Gigahawk/mech223project/Report/src/report.tex

\documentclass{report}
\usepackage[subpreambles=true]{standalone}
\usepackage[utf8]{inputenc}
\usepackage{import}
\usepackage[titletoc]{appendix}
\usepackage[table]{xcolor}
\usepackage[acronym,toc,numberedsection]{glossaries}
\usepackage{chngcntr}

\makeglossaries

%Add star to first instance of text
\defglsentryfmt{
	\ifglsused{\glslabel}{\hspace{-3pt}\glsgenentryfmt\hspace{-6pt}}{\hspace{-3pt}\glsgenentryfmt *\hspace{-6pt}}
}
\newglossaryentry{funcdecomp}{
	name={functional decomposition},
	description={The breakdown of a complex design into numerous, simpler tasks that the overall design must complete}
}
%\setacronymstyle{long-short}
%\newacronym[description={A quantitative method of scoring that assesses the performance of concepts across weighted criteria using absolute scoring}]{wdmacr}{WDM}{weighted decision-making matrix}
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
	description={The tasks that every design-to-be must complete}
}
\newglossaryentry{conceptfrags}{
	name={concept fragment},
	description={Possible solution to a given function}
}
\newglossaryentry{morph}{
	name={morphological chart},
	description={A methodical way of combining various concept fragments into whole concepts}
}
\newglossaryentry{pot}{
	name={potentiometer},
	description={A component that varies its electrical resistance based on the displacement of the dial on its face from its original position}
}

\newglossaryentry{arduino}{
	name={Arduino},
	description={Integrated computer onto a circuit board that receives input from computer programs and drives output}
}
\newglossaryentry{photores}{
	name={photoresistor},
	description={A component that varies its electrical resistance based on the amount of light it detects}
}
\newglossaryentry{wholeconc}{
	name={whole concept},
	description={Potential complete solution for a design}
}
\newglossaryentry{prototype}{
	name={prototype},
	description={A preliminary or final model that built to test the whole concept and collect information for further improvement}
}

\newglossaryentry{torque}{
	name={torque},
	description={Rotational force that causes the object to rotate about its centre}
}

\newglossaryentry{stalltorqure}{
	name={stall torque},
	description={Produced torque from a device outputs in no rotational motion (zero angular velocity). (it might be caused due to overload of the system)}
}

\newglossaryentry{drumbrake}{
	name={drum brake},
	description={Type of brake that uses friction pads to stop rotation of wheels}
}

\newglossaryentry{axle}{
	name={axle},
	description={Shaft that connects and/or drives two wheels}
}

\newglossaryentry{conical}{
	name={conical wheels},
	description={The shape of wheels commonly used for locomotive wheels which allow turning around corners}
}
\newglossaryentry{gearbox}{
	name={gearbox},
	description={Machine that transmits mechanical power through meshing gears}
}

\newglossaryentry{winnow}{
	name={winnowing},
	description={Process that is used to screen out concepts based on feasibility, requirements, and technical readiness}
}
\newglossaryentry{techready}{
	name={technical readiness},
	description={Process of researching for availability and ease of manufacturing, operating, and disposing}
}
\newglossaryentry{eval}{
	name={Evaluation},
	description={One of the design stages which involves concept evaluation and selection using qualitative (Pugh Chart, WDM, etc.) and quantitative methods (calculations)}
}
\newglossaryentry{datum}{
	name={Datum},
	description={Well-known design that is used as reference  }
}
\newglossaryentry{friction}{
	name={Friction},
	description={Type of contact force that always opposes motion}
}
\newglossaryentry{pla}{
	name={PLA},
	description={Commonly used 3D-printing material}
}
\newglossaryentry{pulleydrive}{
	name={pulley drive system},
	description={One type of power transmission that uses rubber belt that’s wrapped around two synchronically rotating pulleys of various sizes}
}
\newglossaryentry{chassis}{
	name={Chassis},
	description={The lower frame of the train which supports internal elements of the train}
}
\newglossaryentry{gyro}{
	name={Gyroscope},
	description={Sensory device that’s used for navigation and detection of angular velocity (orientation about a pivot) }
}

\newglossaryentry{gearratio}{
	name={Gear Ratio},
	description={Input speed on first gear relative to output speed on the last gear}
}

\newglossaryentry{motor}{
	name={Motor},
	description={Device that converts electrical energy to rotational energy}
}

\title{Design Considerations for an Electric Locomotive}
\author{Adrian Lam - 23735160, Aliia Almazbekova - 24346158, David Stewart - 54071155,Jacky Chang - 19835164, Janelle Lawson - 36470169, Jasper Chan - 37467164, Matteo Ferraresso - 36470169}
\for{MECH223 and MECH226 Instructors, University of British Columbia}

\runningheader{\large Design of an Electric Locomotive}

\begin{document}

\pagenumbering{roman}

\maketitle

\setcounter{page}{2}

\tableofcontents

\newpage

\addcontentsline{toc}{section}{\listfigurename}
\listoffigures
\newpage

\addcontentsline{toc}{section}{\listtablename}
\listoftables
\newpage

\import{sections/}{abstract}
\addcontentsline{toc}{section}{Abstract}
\clearpage

\pagenumbering{arabic}

\import{sections/}{introduction}
\clearpage

\import{sections/}{strategy}
\clearpage

\import{sections/}{functional_decomposition}
\clearpage

\import{sections/}{conceptual_solutions}
\clearpage

\import{sections/}{evaluation}
\clearpage

\import{sections/}{results}
\clearpage

\import{sections/}{recommendations}
\clearpage

\import{sections/}{conclusion}
\clearpage

\printglossaries
\printnoidxglossaries
\clearpage

\import{sections/appendices/}{references}
\clearpage

\begin{appendices}
	\counterwithin{figure}{section}
	\counterwithin{table}{section}
	\import{sections/appendices/}{func_decomp}
	\clearpage

	\import{sections/appendices/}{concepts.tex}
	\clearpage

	\import{sections/appendices/}{winnowing.tex}
	\clearpage

	\import{sections/appendices/}{pugh.tex}
	\clearpage

	\import{sections/appendices/}{prototype_tests.tex}
	\clearpage

	\import{sections/appendices/}{wdm.tex}
	\clearpage

	\import{sections/appendices/}{cost_estimates.tex}
	\clearpage

	\import{sections/appendices/}{final_prototype_details.tex}
	\clearpage

	\import{sections/appendices/}{bom.tex}
	\clearpage

\end{appendices}
\end{document}
