Gigahawk/mech223project/Report/src/sections/appendices/references.tex

\documentclass[class=../../report, crop=false]{standalone}

\begin{document}

% Print everything
\nocite{*}
% Print section header for bibliography (apparently this is the right way to make the references a section)
\printbibheading[heading=bibnumbered]

\printbibliography[heading=none]

\end{document}
