Gigahawk/mech223project/Report/bin/funcdecomp-5.pdf

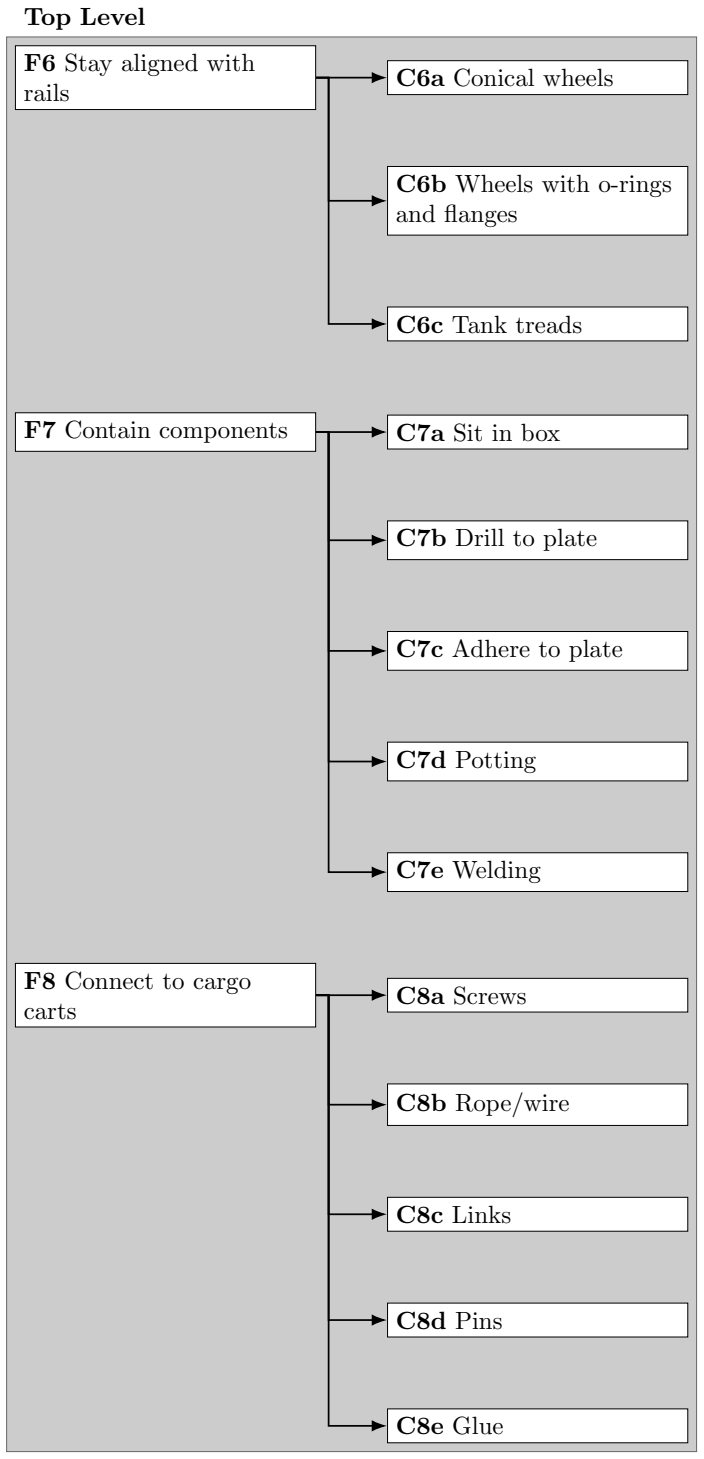
[picture p16: figure]
F6 Stay aligned with; rails; C6a Conical wheels; C6b Wheels with o-rings and flanges; C6c Tank treads; F7 Contain components; C7a Sit in box; C7b Drill to plate; C7c Adhere to plate; C7d Potting; C7e Welding; F8 Connect to cargo; carts; C8a Screws; C8b Rope/wire; C8c Links; C8d Pins; C8e Glue; Top Level
