Gigahawk/mech223project/Report/bin/projplanning.pdf

Running head:

# Tutorial 1-1: Project Management

for

MECH 223 Instructors

University of British Columbia

by

Group D1:

Aliia Almazbekova - 24346158

Jasper Chan - 37467164

Jacky Chan - 19835164

Matteo Ferraresso - 36470169

Adrian Lam - 23735160

Janelle Lawson - 34680165

David Stewart - 54071155

April 3, 2018

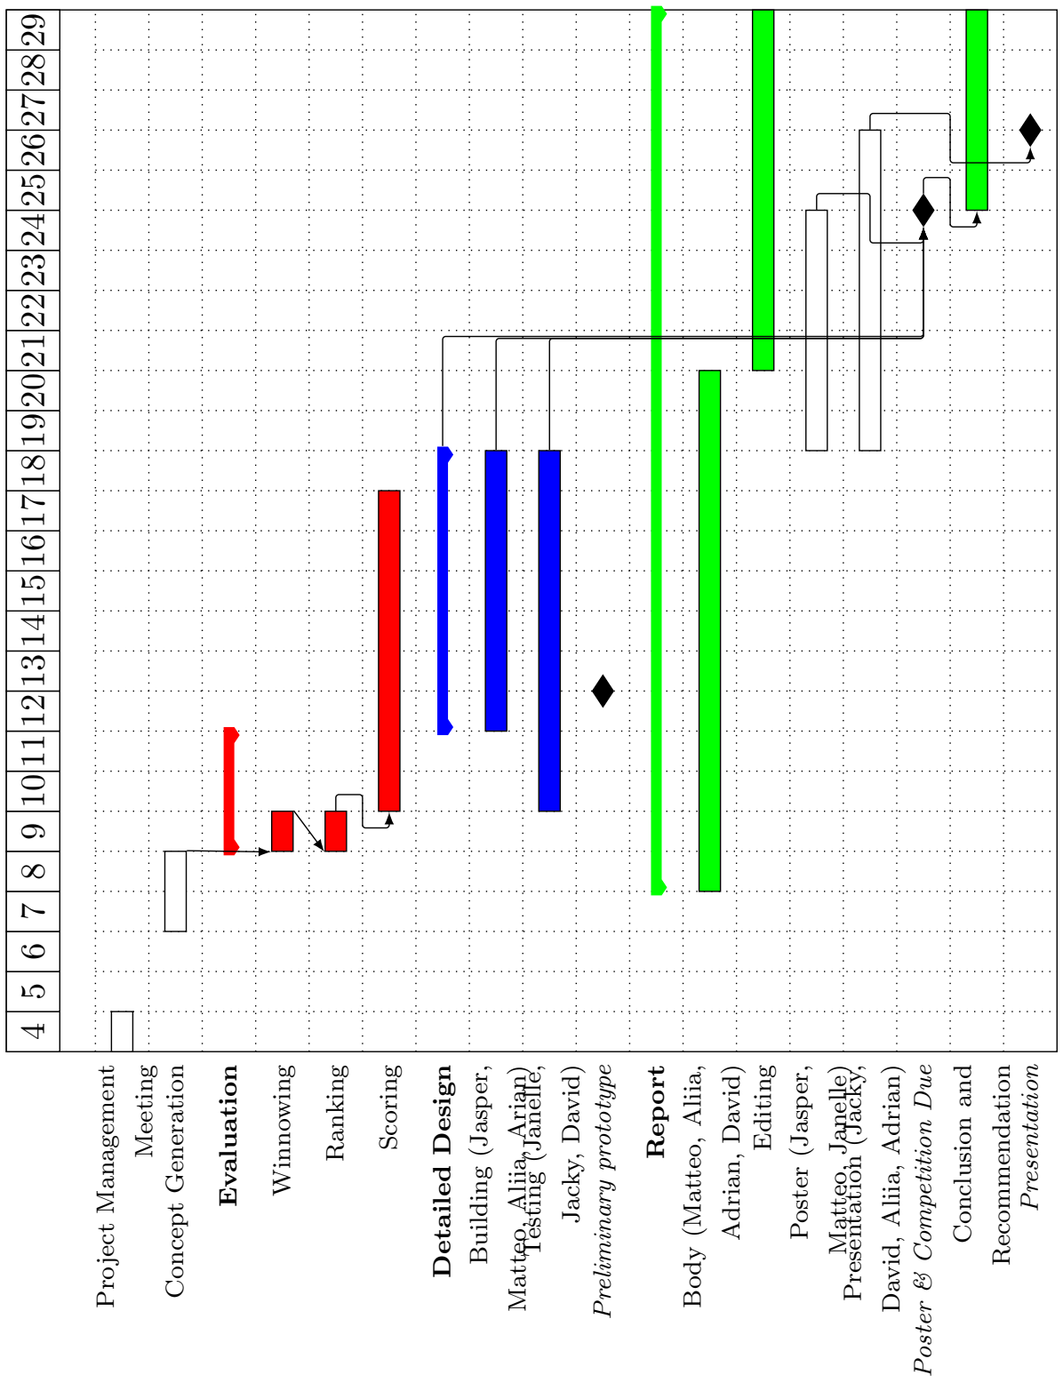
[picture p17: figure]
Project Management; Meeting; Concept Generation; Evaluation; Winnowing; Ranking; Scoring; Detailed Design; Building (Jasper,; Matteo, Aliia, Arian) Testing (Janelle,; Jacky, David); Preliminary prototype; Report; Body (Matteo, Aliia,; Adrian, David); Editing; Poster (Jasper,; Matteo, Janelle) Presentation (Jacky,; David, Aliia, Adrian); Poster & Competition Due; Conclusion and; Recommendation; Presentation

4 5 6 7 8 9 10 11 12 13 14 15 16 17 18 19 20 21 22 23 24 25 26 27 28 29

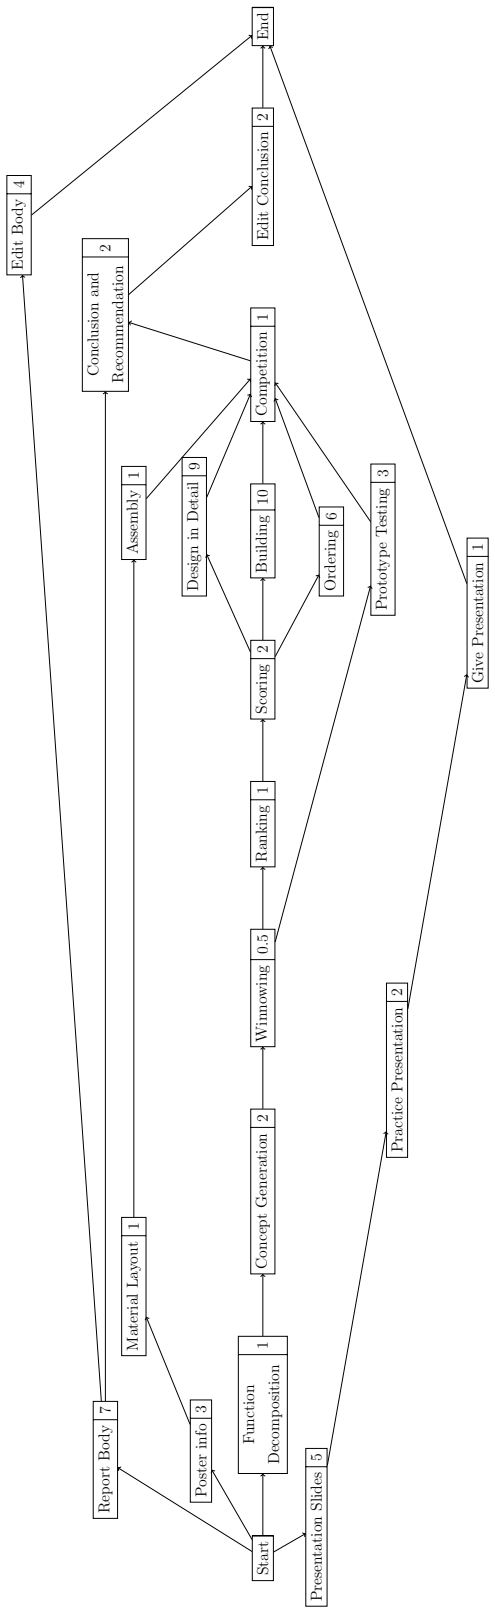
[picture p18: figure]
Start; Report Body 7; Edit Body 4; Poster info 3; Material Layout 1 Assembly 1; Presentation Slides 5; Practice Presentation 2; Give Presentation 1; Function; Decomposition; 1 Concept Generation 2 Winnowing 0.5; Prototype Testing 3; Ranking 1 Scoring 2; Design in Detail 9; Ordering 6; Building 10 Competition 1; Conclusion and; Recommendation; Edit Conclusion 2 End
