Gigahawk/mech223project/Report/bin/toplevel.pdf

F1 Accelerate relative to
Ground

F2 Decelerate relative to
ground

F3 Detect turns

F4 Turn relative to
ground

F5 Move up a hill

F6 Contain components

F7 Connect to cargo
carts

F8 Stay aligned with
rails

Top Level
