Gigahawk/mech223project/Report/bin/turn_relative_to_ground.pdf

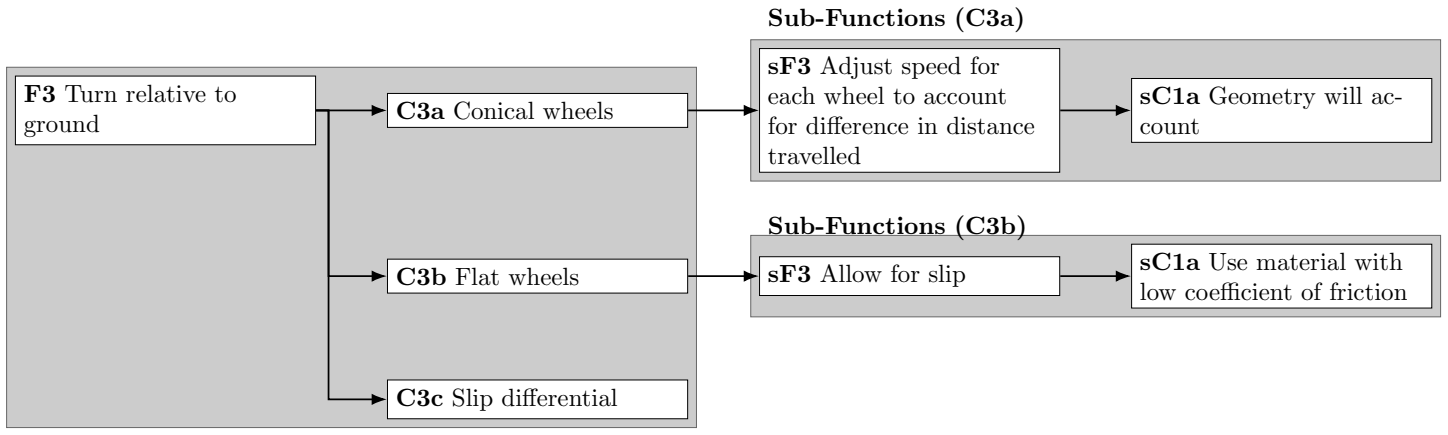
[picture p19: figure]
F3 Turn relative to; ground; C3a Conical wheels; sF3 Adjust speed for each wheel to account for difference in distance travelled; sC1a Geometry will ac- count; C3b Flat wheels; sF3 Allow for slip; sC1a Use material with; low coefficient of friction; C3c Slip differential; Sub-Functions (C3a); Sub-Functions (C3b)
