Gigahawk/mech223project/Report/src/bin/func_decomp.pdf

## 1 Functional Decomposition Diagram

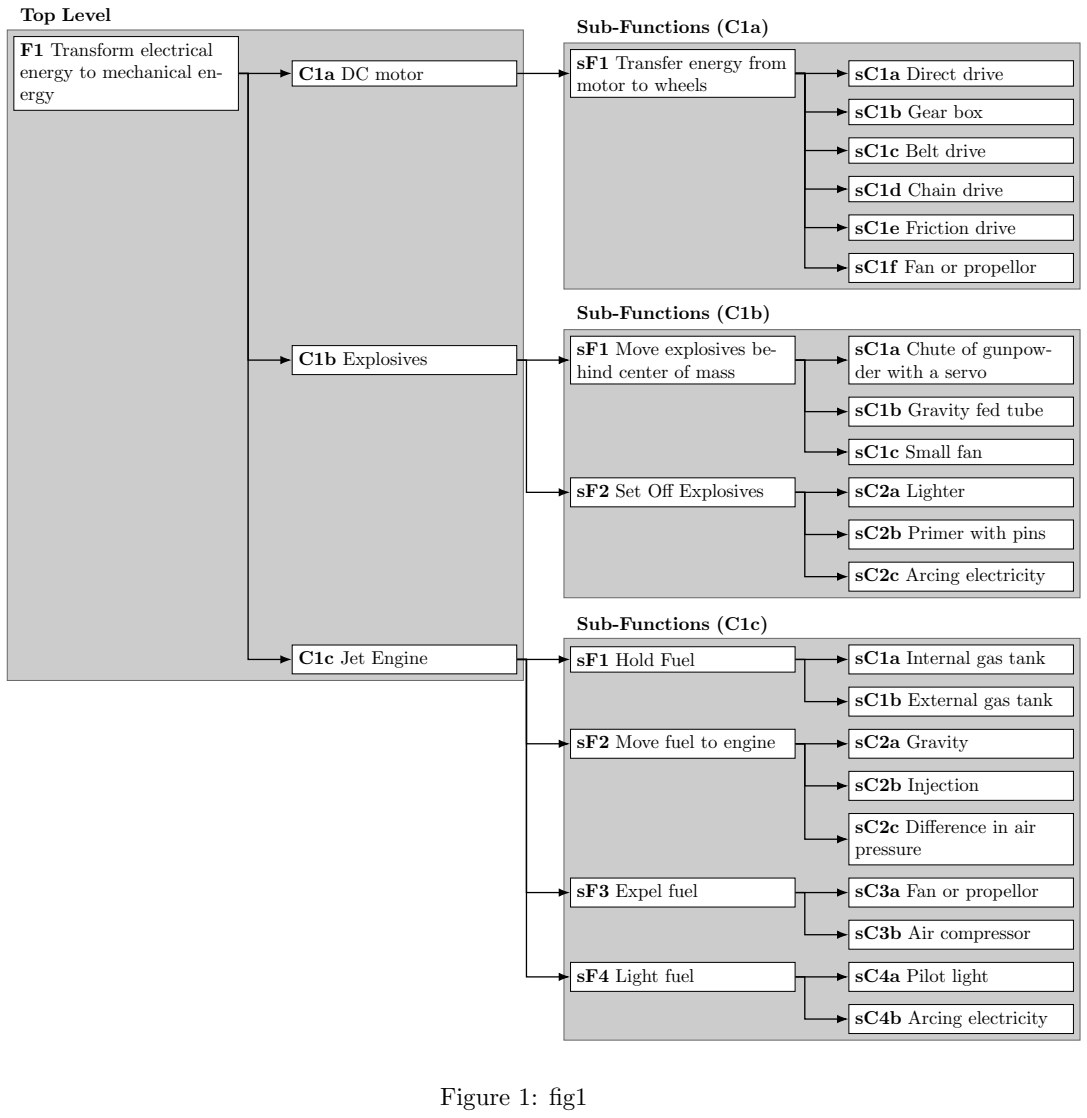
[picture p20: figure]
F1 Transform electrical energy to mechanical en- ergy; C1a DC motor; sF1 Transfer energy from; motor to wheels; sC1a Direct drive; sC1b Gear box; sC1c Belt drive; sC1d Chain drive; sC1e Friction drive; sC1f Fan or propellor; C1b Explosives; sF1 Move explosives be-; hind center of mass; sC1a Chute of gunpow- der with a servo; sC1b Gravity fed tube; sC1c Small fan; sF2 Set Off Explosives; sC2a Lighter; sC2b Primer with pins; sC2c Arcing electricity; C1c Jet Engine; sF1 Hold Fuel; sC1a Internal gas tank; sC1b External gas tank; sF2 Move fuel to engine; sC2a Gravity; sC2b Injection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

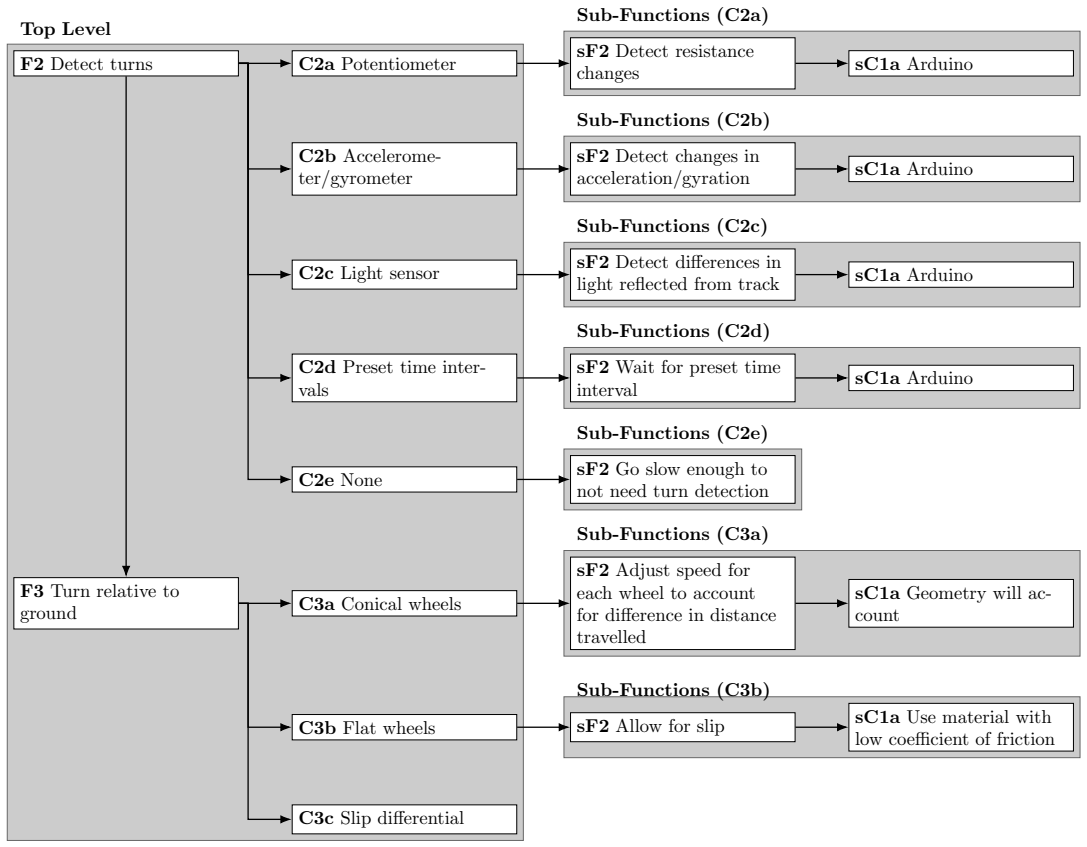
[picture p21: figure]
F2 Detect turns; C2a Potentiometer; sF2 Detect resistance; changes; sC1a Arduino; C2b Accelerome- ter/gyrometer; sF2 Detect changes in; acceleration/gyration; C2c Light sensor; sF2 Detect differences in; light reflected from track; C2d Preset time inter- vals; sF2 Wait for preset time; interval; C2e None; sF2 Go slow enough to; not need turn detection; F3 Turn relative to; ground; C3a Conical wheels; sF2 Adjust speed for each wheel to account for difference in distance travelled; sC1a Geometry will ac- count; C3b Flat wheels; sF2 Allow for slip; sC1a Use material with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

## Figure 1: fig2

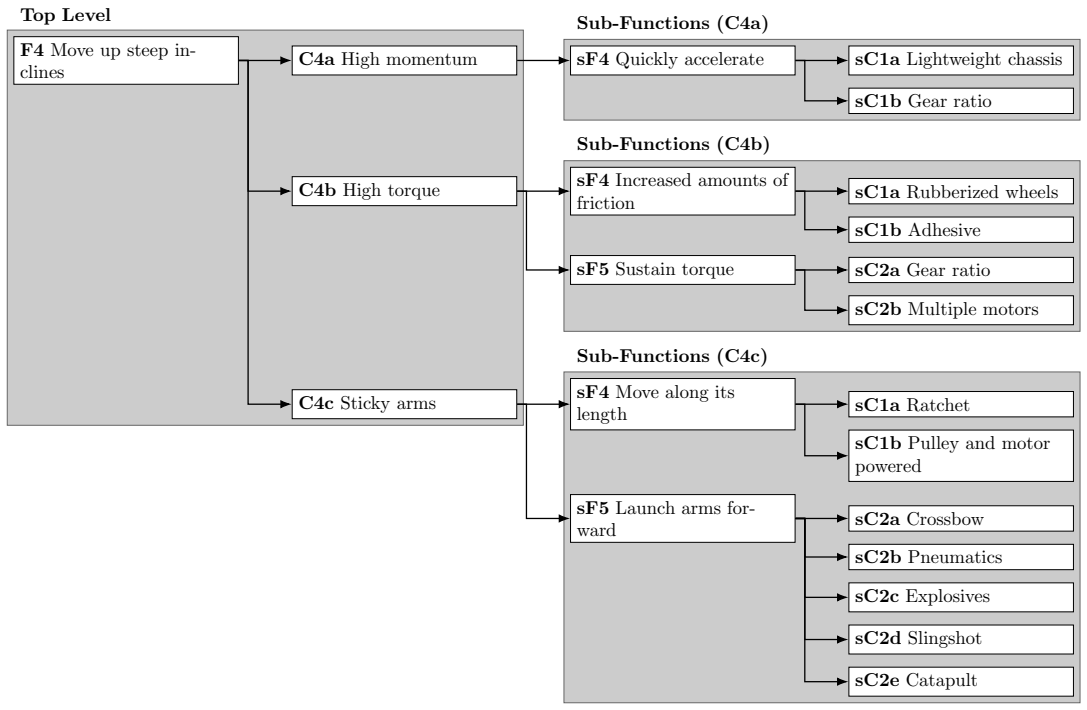
[picture p22: figure]
F4 Move up steep in-; clines; C4a High momentum; sF4 Quickly accelerate; sC1a Lightweight chassis; sC1b Gear ratio; C4b High torque; sF4 Increased amounts of; friction; sC1a Rubberized wheels; sC1b Adhesive; sF5 Sustain torque; sC2a Gear ratio; sC2b Multiple motors; C4c Sticky arms; sF4 Move along its; length; sC1a Ratchet; sC1b Pulley and motor powered; sF5 Launch arms for-; ward; sC2a Crossbow; sC2b Pneumatics; sC2c Explosives; sC2d Slingshot; sC2e Catapult; Top Level; Sub-Functions (C4a); Sub-Functions (C4b); Sub-Functions (C4c)

## Figure 1: fig2

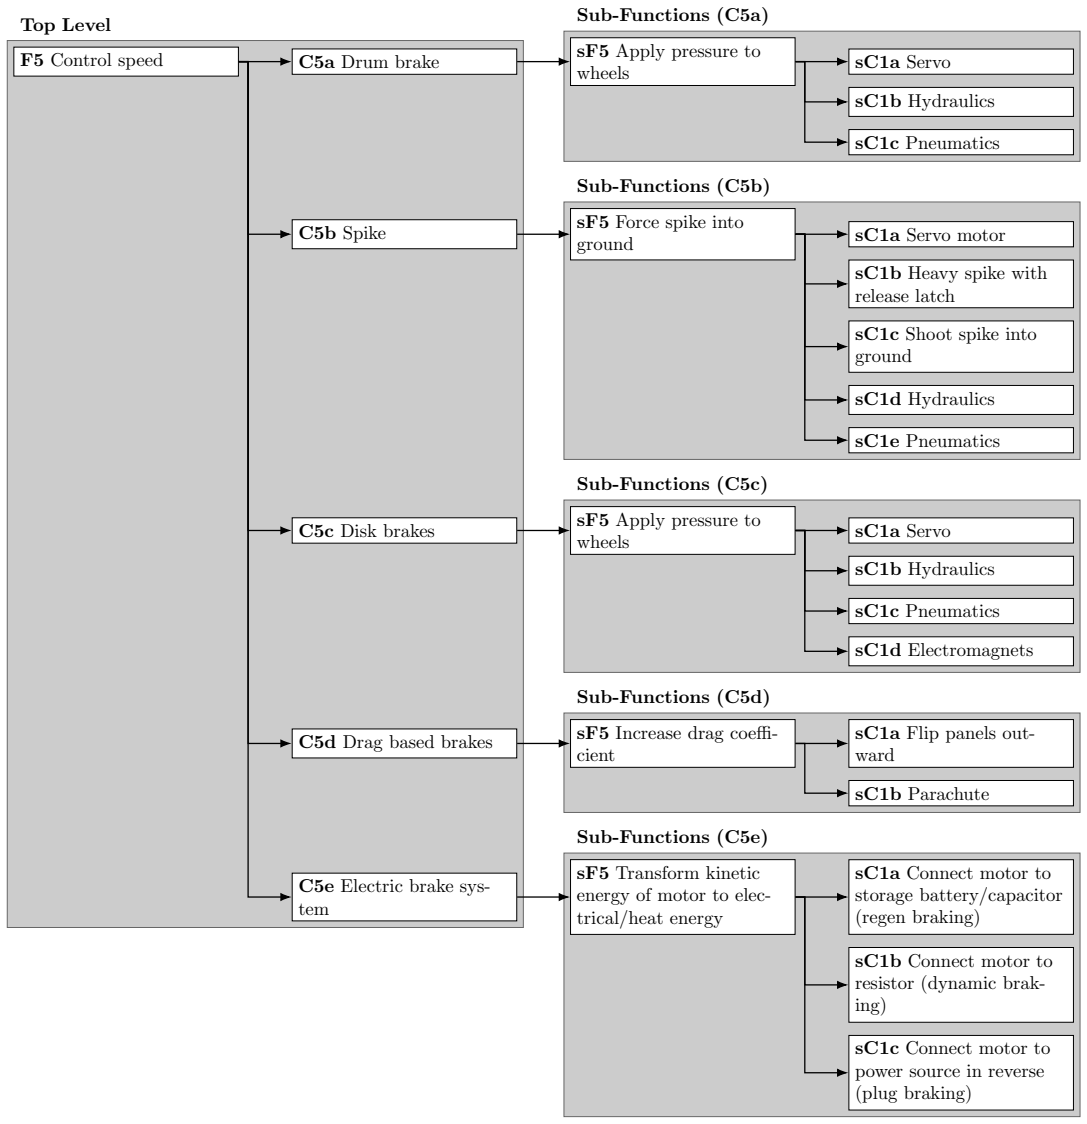
[picture p23: figure]
F5 Control speed; C5a Drum brake; sF5 Apply pressure to; wheels; sC1a Servo; sC1b Hydraulics; sC1c Pneumatics; C5b Spike; sF5 Force spike into; ground; sC1a Servo motor; sC1b Heavy spike with release latch; sC1c Shoot spike into ground; sC1d Hydraulics; sC1e Pneumatics; C5c Disk brakes; sC1d Electromagnets; C5d Drag based brakes; sF5 Increase drag coeffi-; cient; sC1a Flip panels out- ward; sC1b Parachute; C5e Electric brake sys- tem; sF5 Transform kinetic energy of motor to elec- trical/heat energy; sC1a Connect motor to storage battery/capacitor (regen braking)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

## Figure 1: fig2

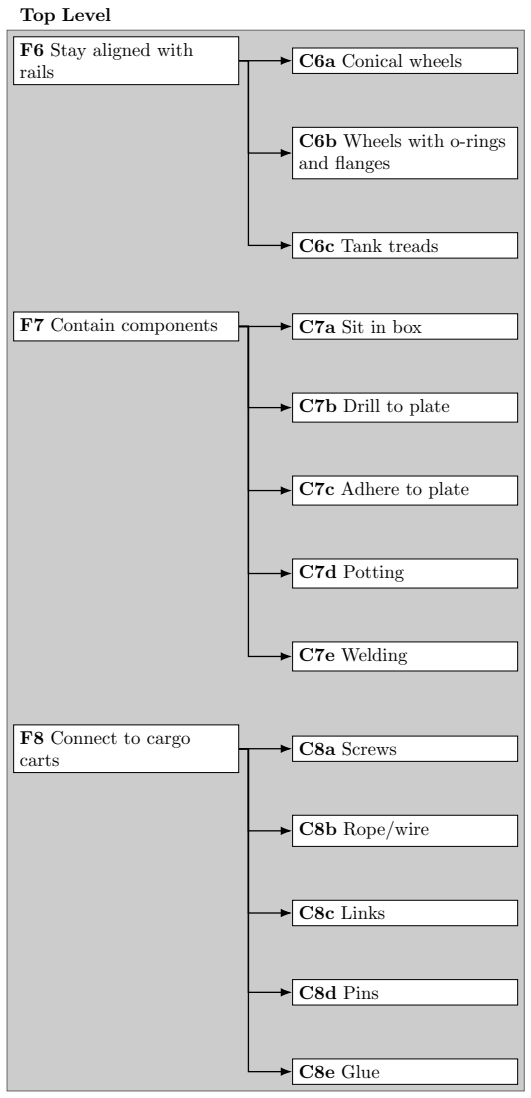
[picture p24: figure]
F6 Stay aligned with; rails; C6a Conical wheels; C6b Wheels with o-rings and flanges; C6c Tank treads; F7 Contain components; C7a Sit in box; C7b Drill to plate; C7c Adhere to plate; C7d Potting; C7e Welding; F8 Connect to cargo; carts; C8a Screws; C8b Rope/wire; C8c Links; C8d Pins; C8e Glue; Top Level

## Figure 1: fig2
