Gigahawk/mech223project/Report/src/sections/appendices/pugh.tex

\documentclass[class=../../report, crop=false]{standalone}
\usepackage{graphicx}
\usepackage{mathtools}
\usepackage{float}
\usepackage{rotating}
\usepackage{caption}

\begin{document}
\section{Pugh Charts} \label{app:pugh}
\mbox{} \begin{center}
	\begin{sideways}
		\begin{minipage}{1.1\textwidth}
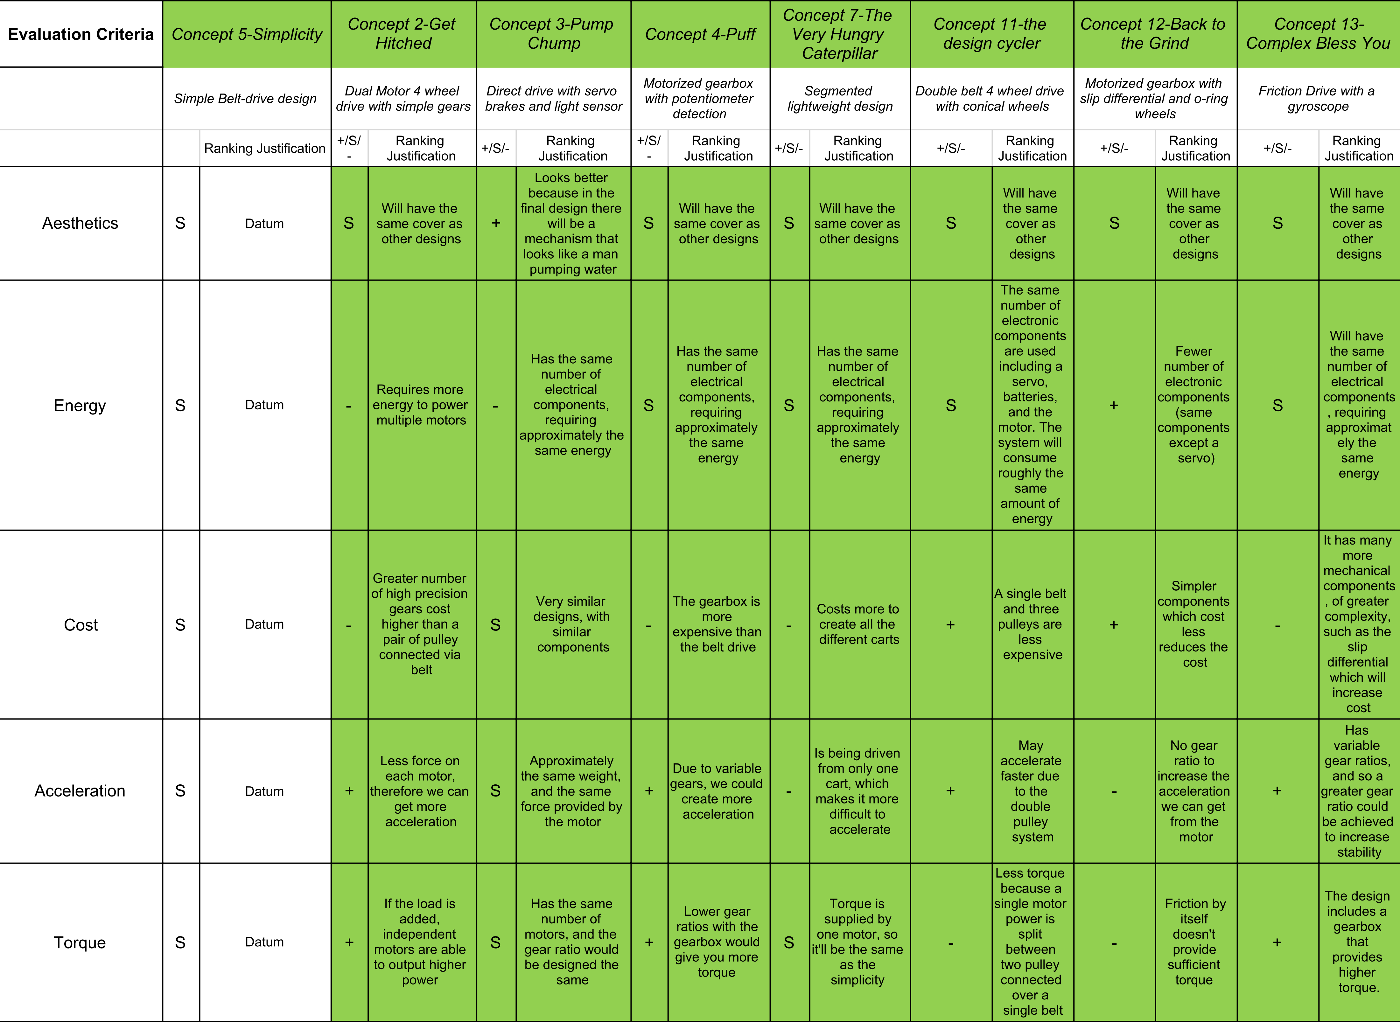
[picture p25: Report/src/res/img/pugh1-1.png]
			
			\captionof{table}{Pugh Chart using Simplicity as a Datum}
			\label{app/table:pughsimplicity1}
		\end{minipage}
	\end{sideways}
\end{center}
\mbox{} \begin{center}
\begin{sideways}
	\begin{minipage}{1.25\textwidth}
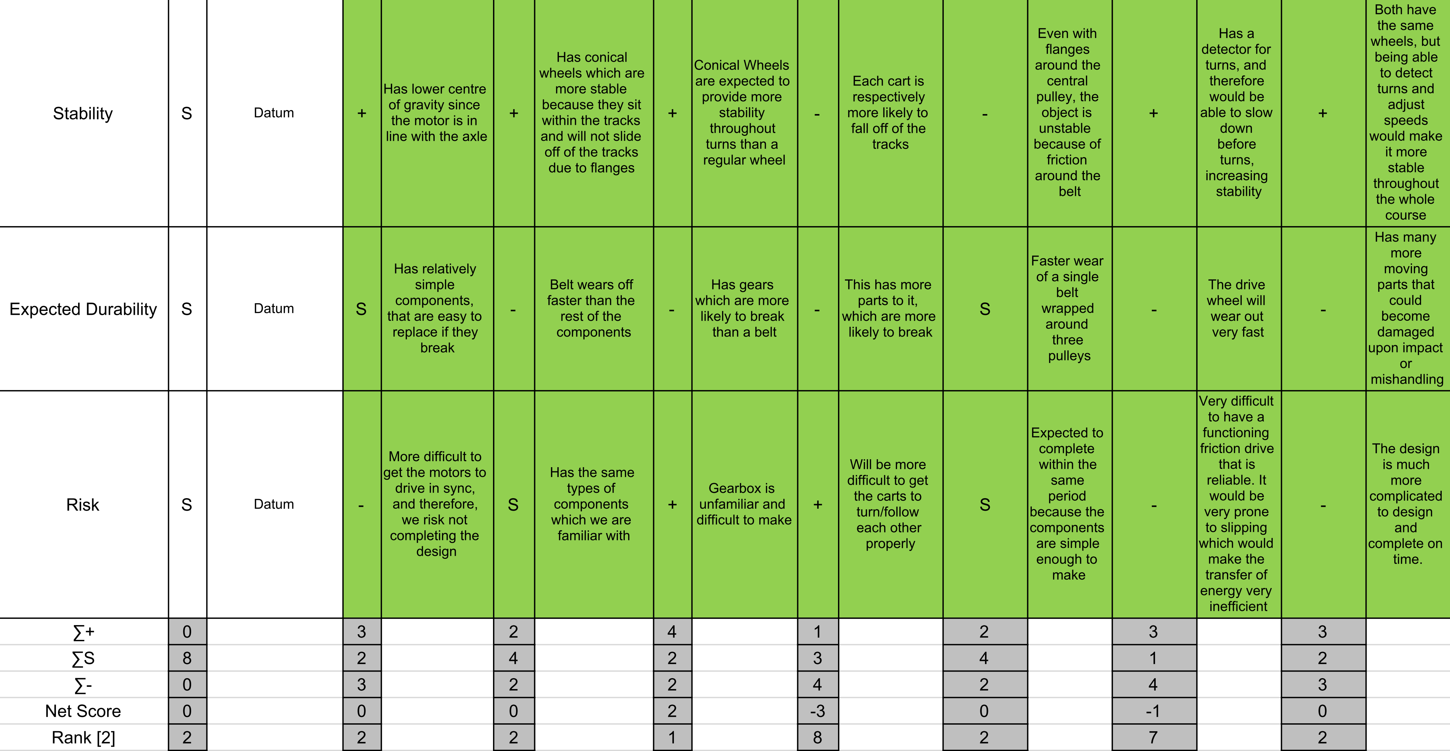
[picture p26: Report/src/res/img/pugh1-2.png]
		
		\captionof{table}{Pugh Chart using Simplicity as a Datum}
		\label{app/table:pughsimplicity2}
	\end{minipage}
\end{sideways}
\end{center}
\mbox{} \begin{center}
	\begin{sideways}
		\begin{minipage}{1.25\textwidth}
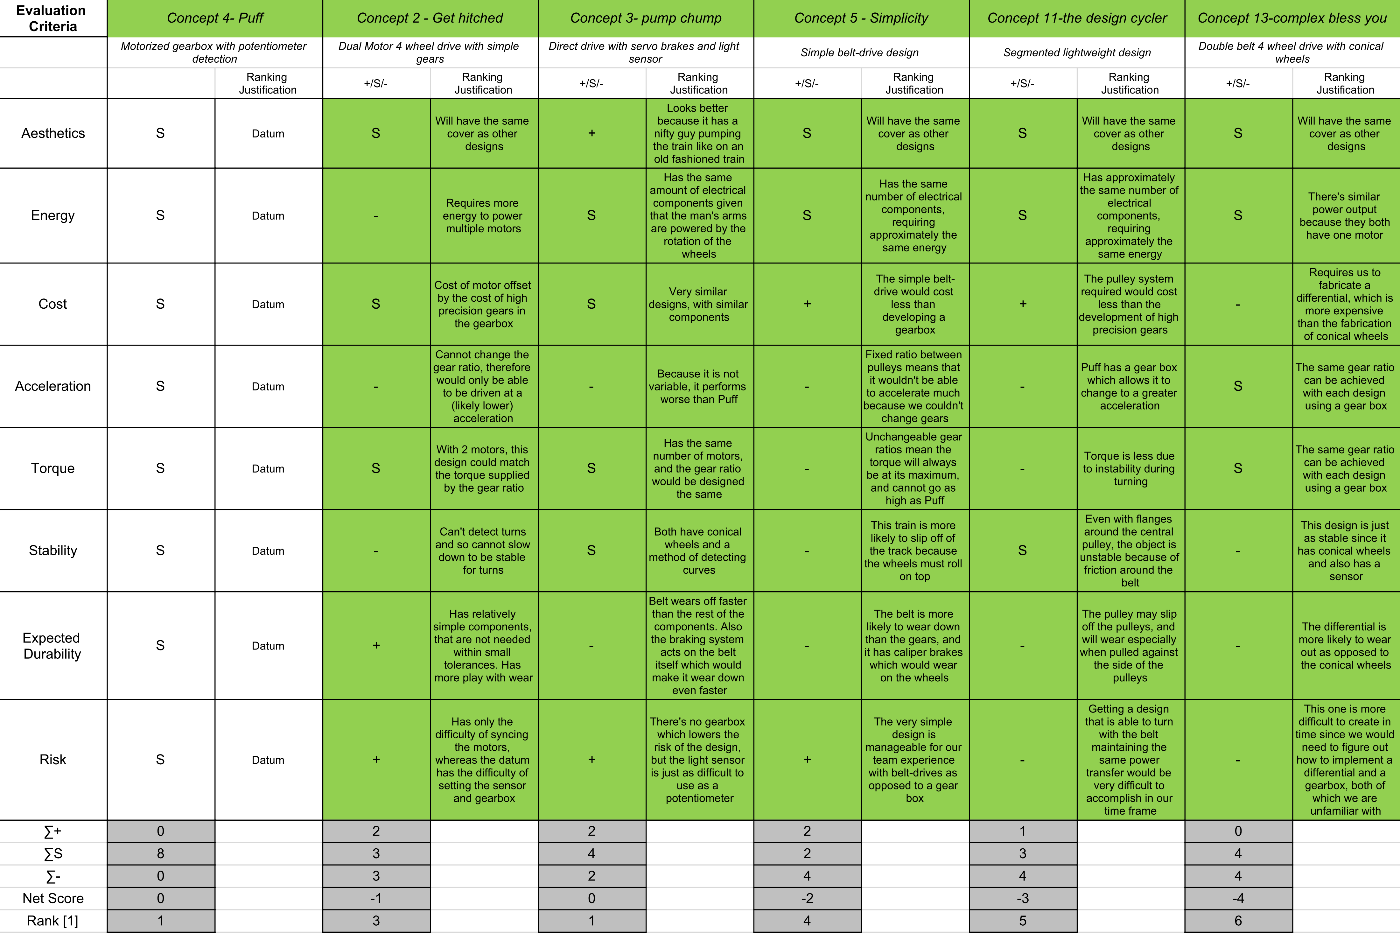
[picture p27: Report/src/res/img/pugh2-1.png]
			
			\captionof{table}{Pugh Chart using Puff as a Datum}
			\label{app/table:pughpuff}
		\end{minipage}
	\end{sideways}
\end{center}

\end{document}
