Gigahawk/mech223project/Report/src/sections/appendices/wdm.tex

\documentclass[class=../../report, crop=false]{standalone}
\usepackage{graphicx}
\usepackage{mathtools}
\usepackage{float}
\usepackage{rotating}
\usepackage{caption}

\begin{document}
\section{Weighted Decision Matrix} \label{app:wdm}
\mbox{} \begin{center}
	\begin{sideways}
		\begin{minipage}{1.1\textwidth}
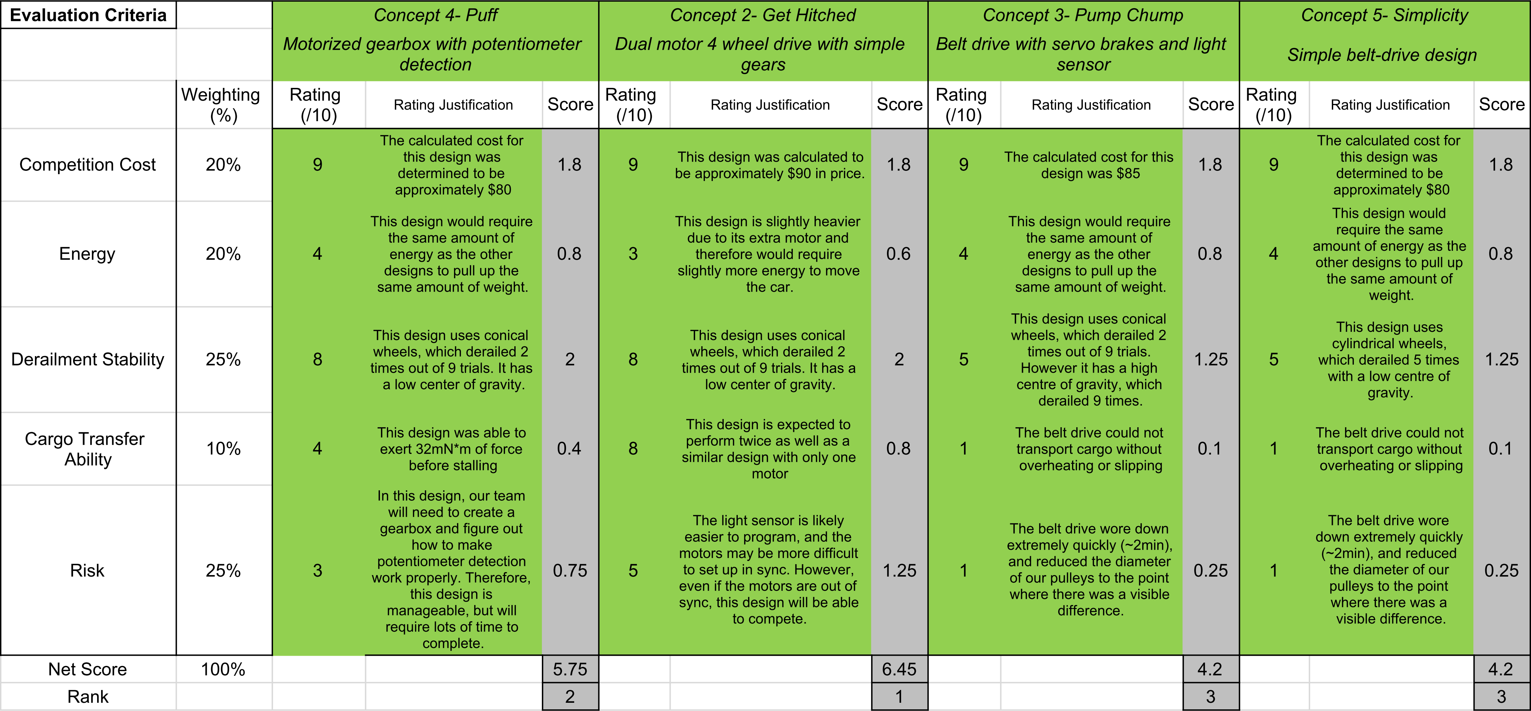
[picture p28: Report/src/res/img/wdmregular.png]
			
			\captionof{table}{Weighted Decision Matrix}
			\label{app/table:wdm}
		\end{minipage}
	\end{sideways}
\end{center}

\end{document}
