Gigahawk/mech223project/Report/marked/memo_marked.pdf

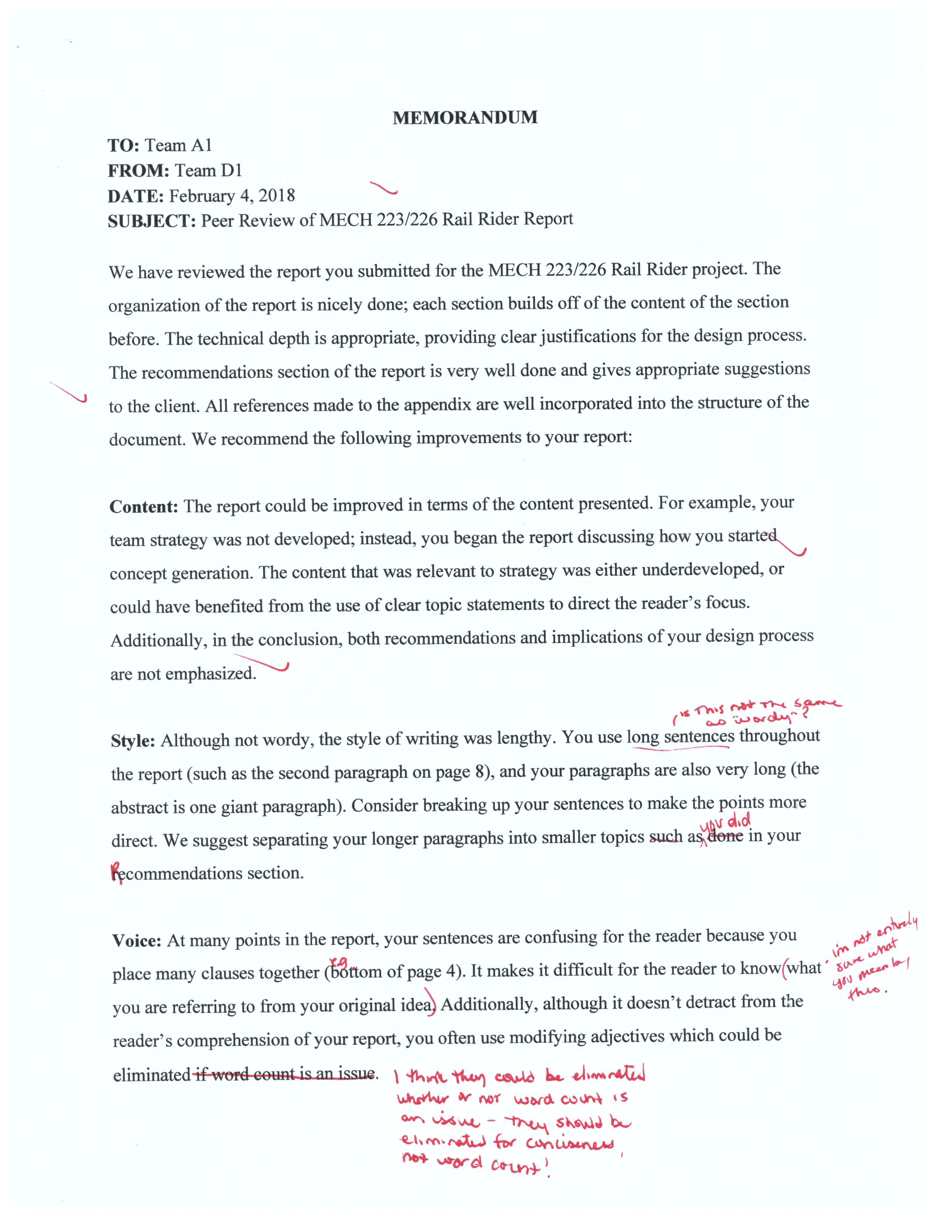
[picture p29: page 1]
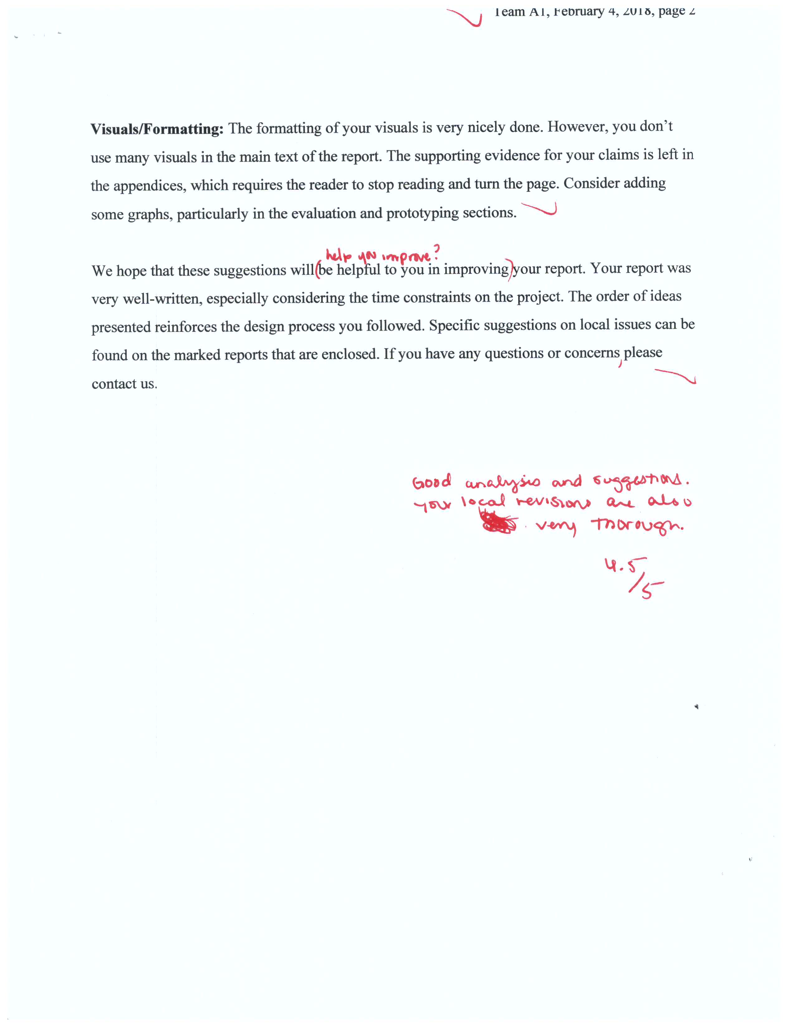
[picture p30: page 2]
