Gigahawk/mech223project/Report/marked/poster_rubric.pdf

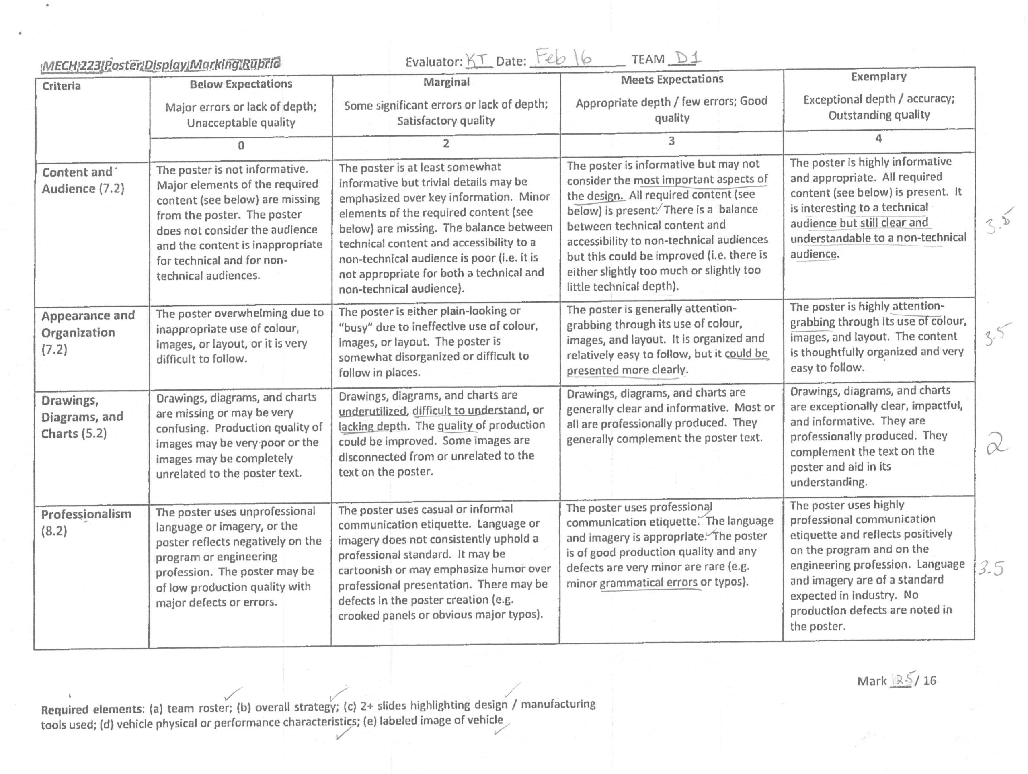
[picture p31: page 1]
