Gigahawk/mech223project/Report/docs/Project 1 Poster Rubric.pdf

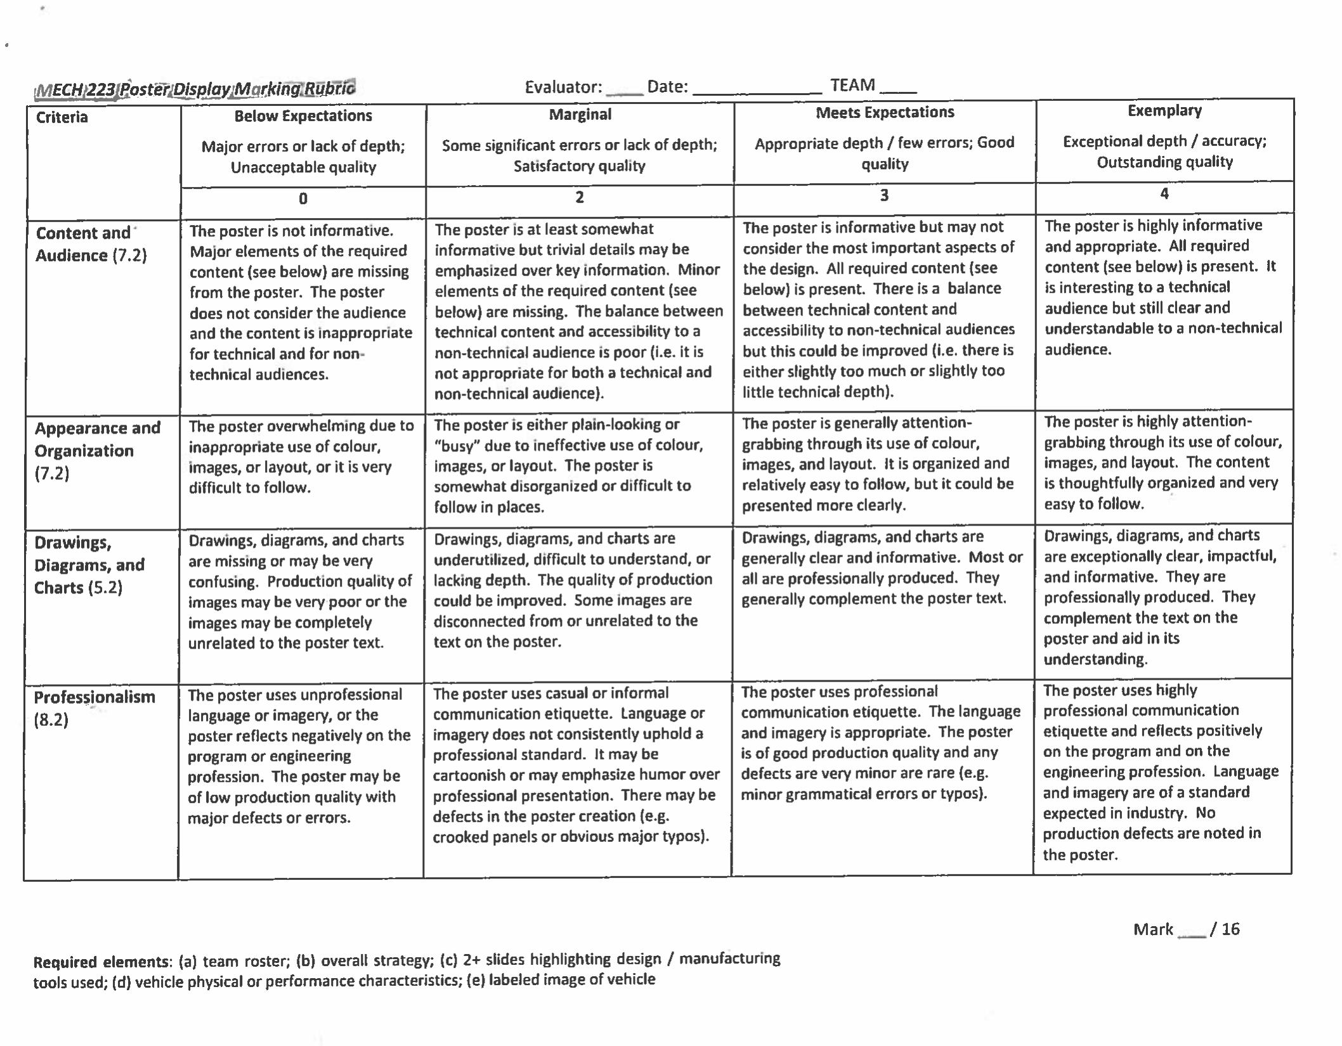
[picture p32: page 1]
