Gigahawk/mech223project/eagle/motor_comp.pdf

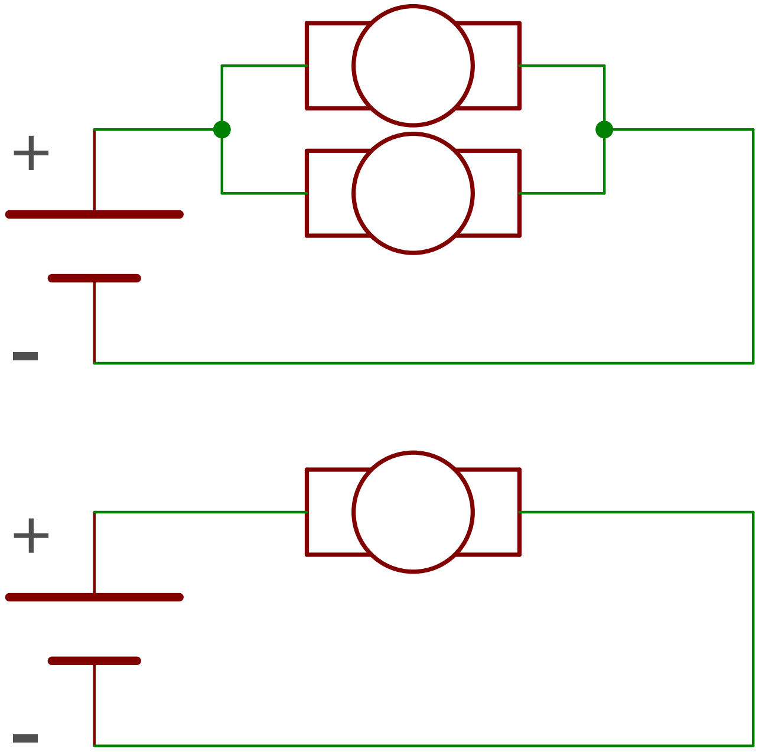
[picture p33: figure]

1/19/2018 5:15 PM f=4.00 C:\Users\Jasper\Documents\eagle\Mech223\MAIN.SCH (Sheet: 1/1)
