Gigahawk/mech223project/Report/src/lightsensor.csv

t | val
1 | 607
2 | 608
3 | 607
4 | 607
5 | 606
6 | 608
7 | 607
8 | 607
9 | 608
10 | 606
11 | 607
12 | 607
13 | 607
14 | 608
15 | 608
16 | 608
17 | 608
18 | 608
19 | 607
20 | 607
21 | 607
22 | 608
23 | 607
24 | 607
25 | 607
26 | 607
27 | 607
28 | 607
29 | 607
30 | 607
31 | 606
32 | 606
33 | 605
34 | 603
35 | 601
36 | 599
37 | 595
38 | 590
39 | 586
40 | 579
41 | 572
42 | 561
43 | 546
44 | 528
45 | 508
46 | 485
47 | 462
48 | 443
49 | 426
50 | 412
51 | 402
52 | 396
53 | 391
54 | 389
55 | 387
56 | 385
57 | 385
58 | 386
59 | 387
60 | 389
61 | 391
62 | 394
63 | 399
64 | 406
65 | 425
66 | 459
67 | 505
68 | 547
69 | 573
70 | 587
71 | 592
72 | 593
73 | 588
74 | 579
75 | 567
76 | 546
77 | 511
78 | 467
79 | 432
80 | 412
81 | 403
82 | 398
83 | 396
84 | 396
85 | 398
86 | 402
87 | 413
88 | 448
89 | 505
90 | 544
91 | 559
92 | 565
93 | 559
94 | 543
95 | 515
96 | 470
97 | 431
98 | 412
99 | 402
100 | 400
101 | 400
102 | 403
103 | 421
104 | 478
105 | 530
106 | 553
107 | 560
108 | 552
109 | 524
110 | 474
111 | 436
112 | 418
113 | 412
114 | 410
115 | 415
116 | 432
117 | 493
118 | 540
119 | 555
120 | 551
121 | 530
122 | 479
123 | 431
124 | 410
125 | 404
126 | 407
127 | 414
128 | 453
129 | 518
130 | 547
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
