Gigahawk/mech223project/Report/src/res/img/pugh2-2.png

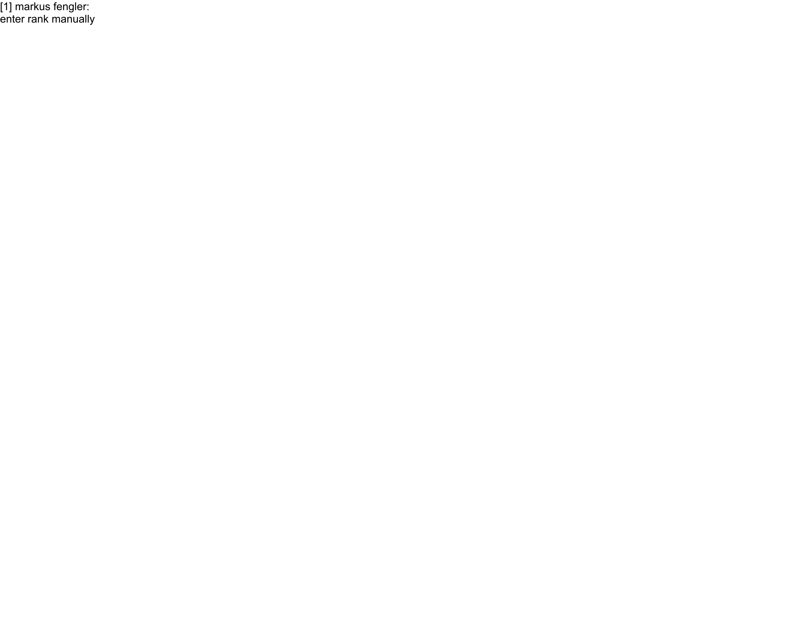
Report/src/res/img/pugh2-2.png
