Gigahawk/mech223project/Report/src/res/img/stuperfalicious.jpg

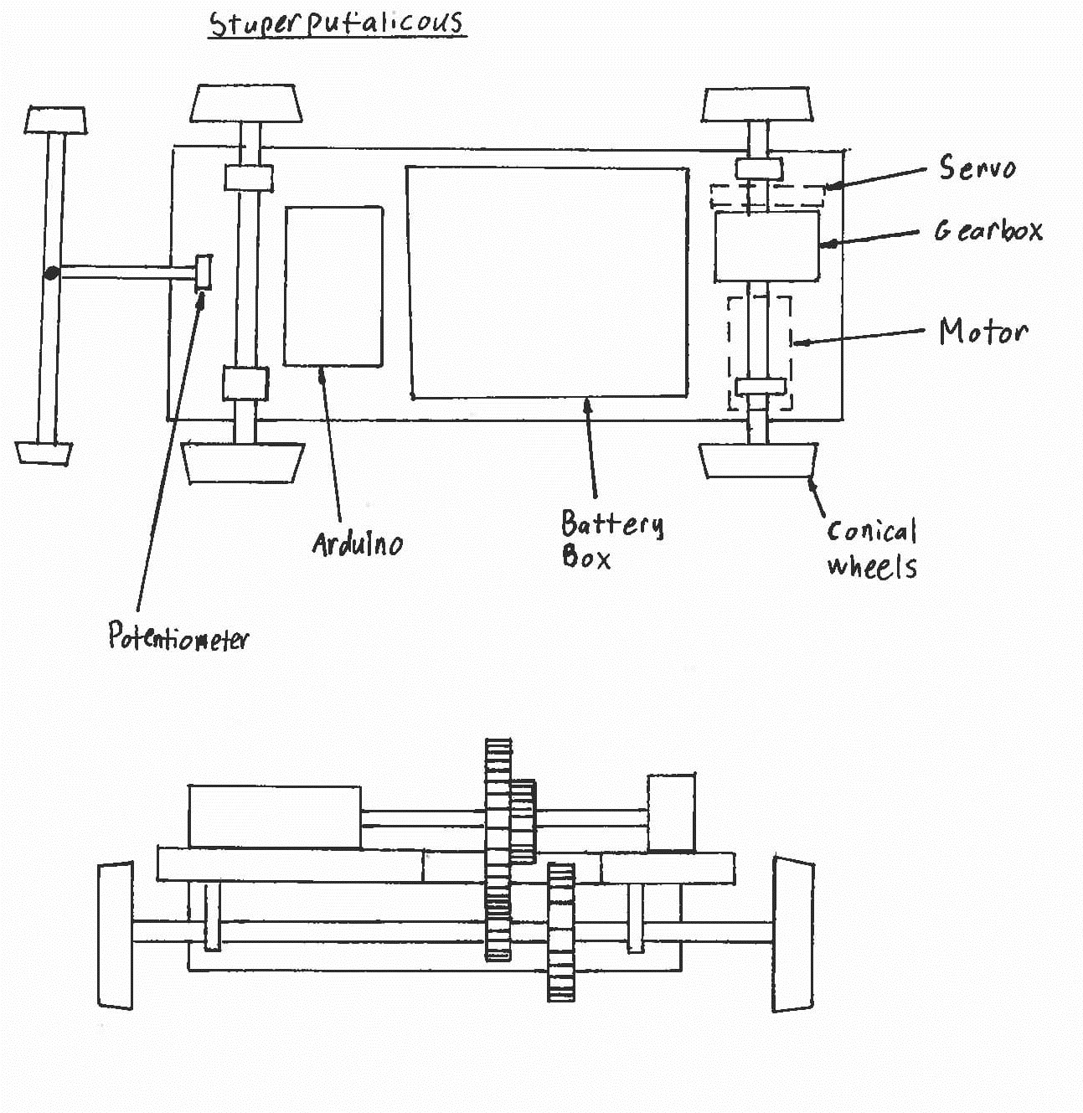
Report/src/res/img/stuperfalicious.jpg
