Gigahawk/mech223project/Report/src/sections/appendices/bom.tex

\documentclass[class=../../report, crop=false]{standalone}
\usepackage{graphicx}
\usepackage{mathtools}
\usepackage{float}
\usepackage{rotating}
\usepackage{caption}

\begin{document}
\section{Bill of Materials} \label{app:bom}
\begin{table}[H]
	\centering
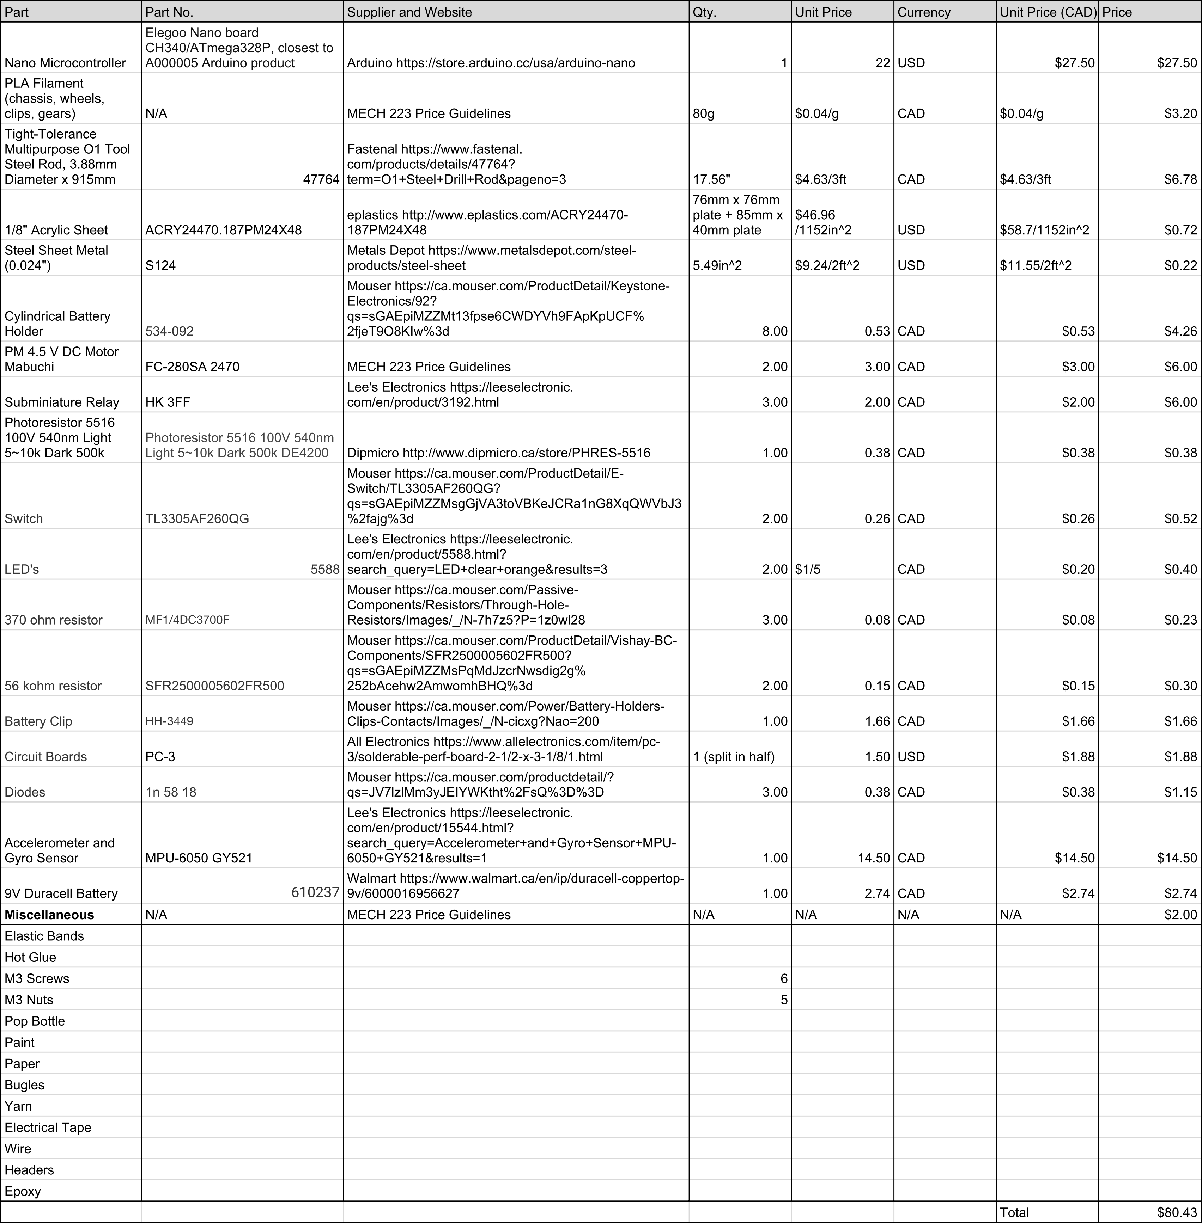
[picture p36: Report/src/res/img/bom.png]
	
	\caption{Bill of Materials}
	\label{app/table:bom}
\end{table}
	
\end{document}
