Gigahawk/mech223project/Report/bin/cpm.pdf

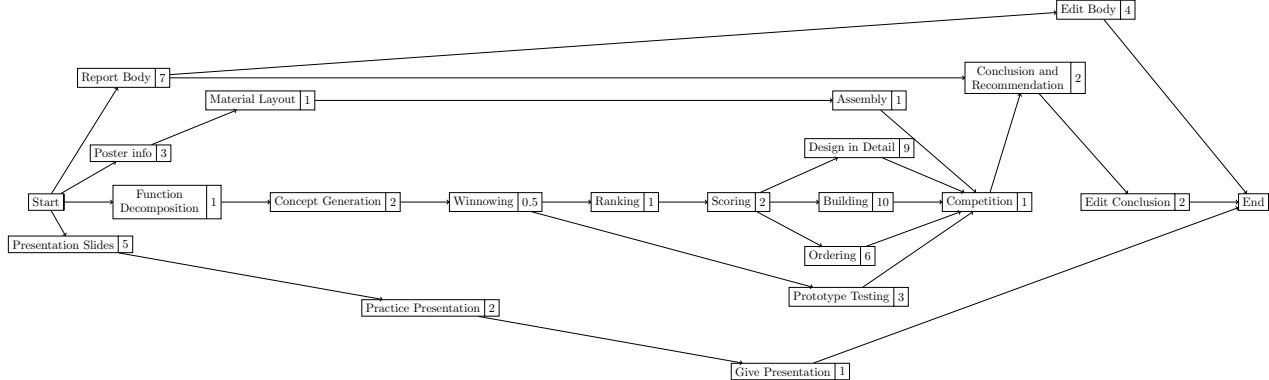
[picture p42: page 1]
Start; Report Body; Edit Body; Material Layout; Assembly; Presentation Slides; Practice Presentation; Give Presentation; Function; Decomposition; Concept Generation; Winnowing; Prototype Testing; Ranking; Scoring; Ordering; Building; Competition; Conclusion and; Recommendation; Edit Conclusion; End

Poster info | 3

Design in Detail | 9
