Gigahawk/mech223project/Report/bin/funcdecomp-1.pdf

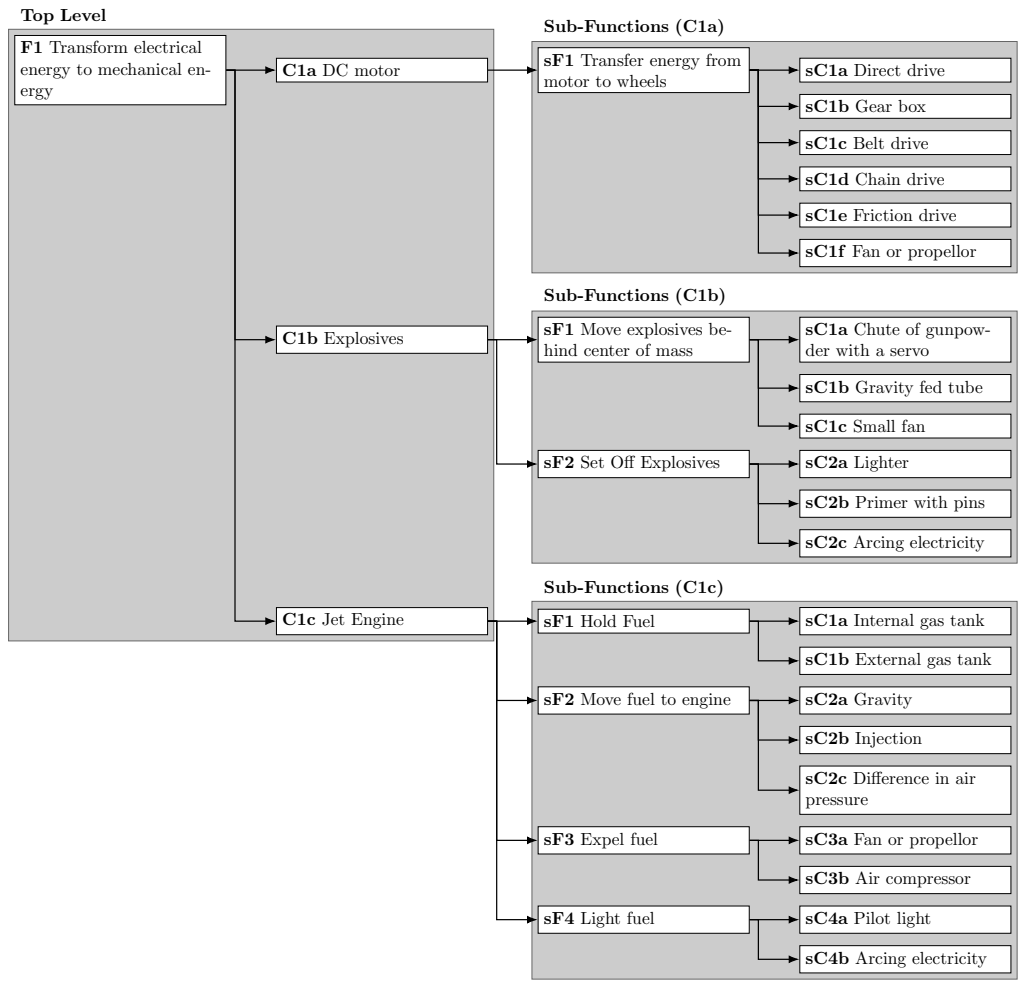
[picture p43: page 1]
C1a DC motor; sF1 Transfer energy from; motor to wheels; sC1a Direct drive; sC1b Gear box; sC1c Belt drive; sC1d Chain drive; sC1e Friction drive; C1b Explosives; sF1 Move explosives be-; sC1c Small fan; sF2 Set Off Explosives; sC2a Lighter; sC2c Arcing electricity; C1c Jet Engine; sF1 Hold Fuel; sC1a Internal gas tank; sF2 Move fuel to engine; sC2a Gravity; sC2b Injection; sF3 Expel fuel; sC3a Fan or propellor; sC3b Air compressor; sF4 Light fuel; sC4a Pilot light; sC4b Arcing electricity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

F1 Transform electrical
energy to mechanical en-
ergy

sC1f Fan or propellor

sC1a Chute of gunpow-
der with a servo

hind center of mass

sC1b Gravity fed tube

sC2b Primer with pins

sC1b External gas tank

sC2c Difference in air
pressure
