Gigahawk/mech223project/Report/bin/funcdecomp-2.pdf

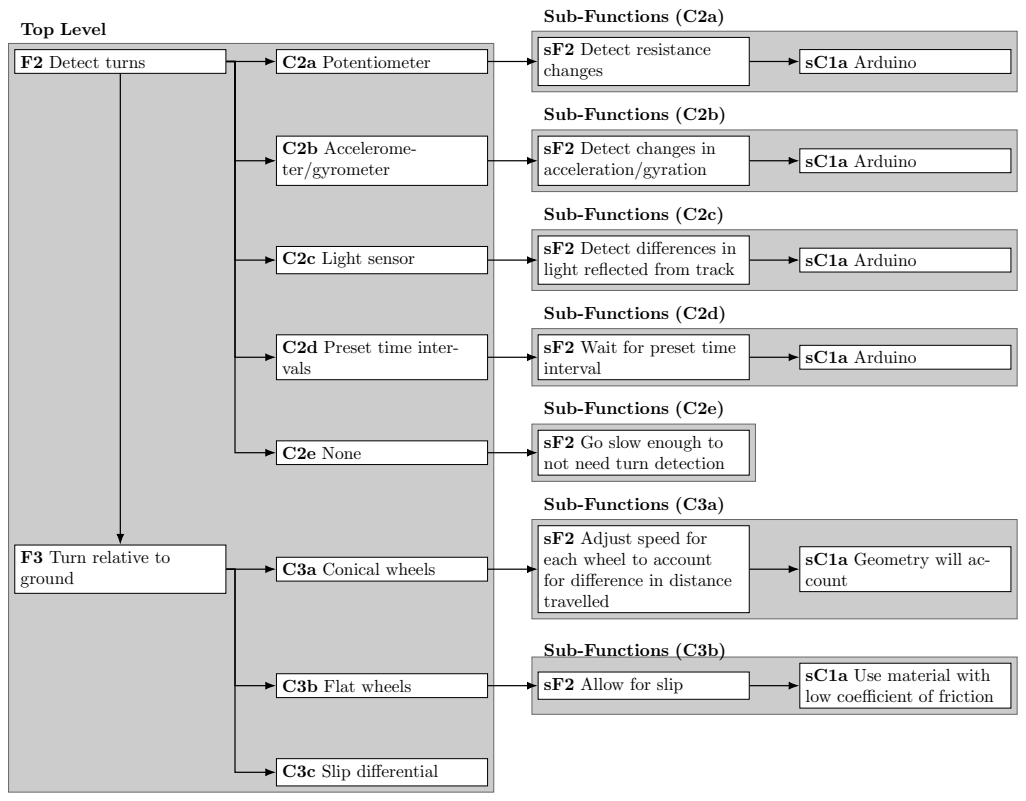
[picture p44: page 1]
F2 Detect turns; C2a Potentiometer; sF2 Detect resistance; changes; sC1a Arduino; C2b Accelerome- ter/gyrometer; acceleration/gyration; C2c Light sensor; sF2 Detect differences in; light reflected from track; interval; C2e None; sF2 Go slow enough to; ground; C3a Conical wheels; C3b Flat wheels; sF2 Allow for slip; sC1a Use material with; C3c Slip differential; Top Level; Sub-Functions (C2a); Sub-Functions (C2b); Sub-Functions (C2c); Sub-Functions (C2d); Sub-Functions (C2e)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

sF2 Detect changes in

C2d Preset time inter-
vals

sF2 Wait for preset time

not need turn detection

sF2 Adjust speed for
each wheel to account
for difference in distance
travelled

F3 Turn relative to

sC1a Geometry will ac-
count

low coefficient of friction
