Gigahawk/mech223project/Report/bin/funcdecomp-4.pdf

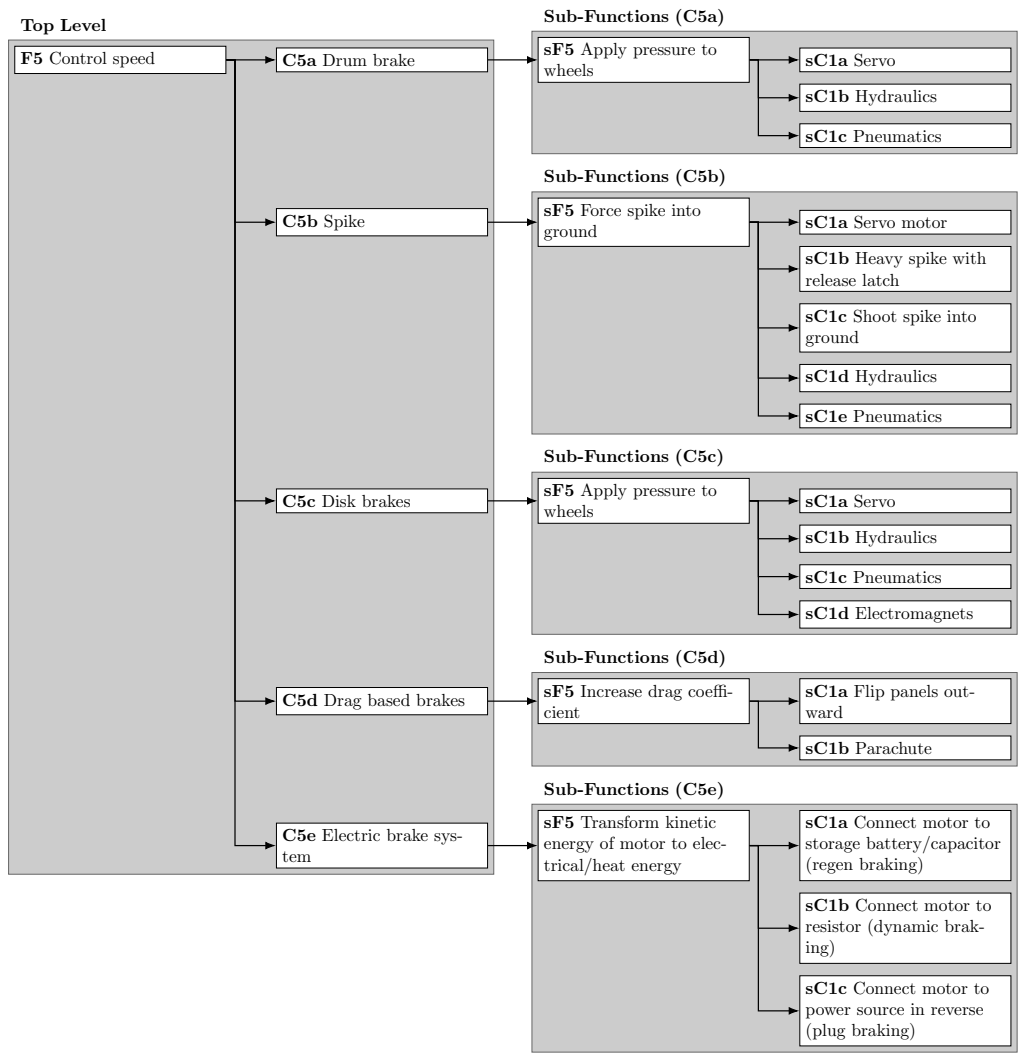
[picture p45: page 1]
F5 Control speed; C5a Drum brake; sF5 Apply pressure to; wheels; sC1a Servo; sC1b Hydraulics; sC1c Pneumatics; C5b Spike; sF5 Force spike into; ground; sC1a Servo motor; sC1d Hydraulics; sC1e Pneumatics; C5c Disk brakes; sC1d Electromagnets; C5d Drag based brakes; sF5 Increase drag coeffi-; cient; sC1b Parachute; Top Level; Sub-Functions (C5a); Sub-Functions (C5b); Sub-Functions (C5c); Sub-Functions (C5d); Sub-Functions (C5e)

sC1b Heavy spike with
release latch

sC1c Shoot spike into
ground

sC1a Flip panels out-
ward

sF5 Transform kinetic
energy of motor to elec-
trical/heat energy

sC1a Connect motor to
storage battery/capacitor
(regen braking)

C5e Electric brake sys-
tem

sC1b Connect motor to
resistor (dynamic brak-
ing)

sC1c Connect motor to
power source in reverse
(plug braking)
