Gigahawk/mech223project/Report/bin/funcdecomp.pdf

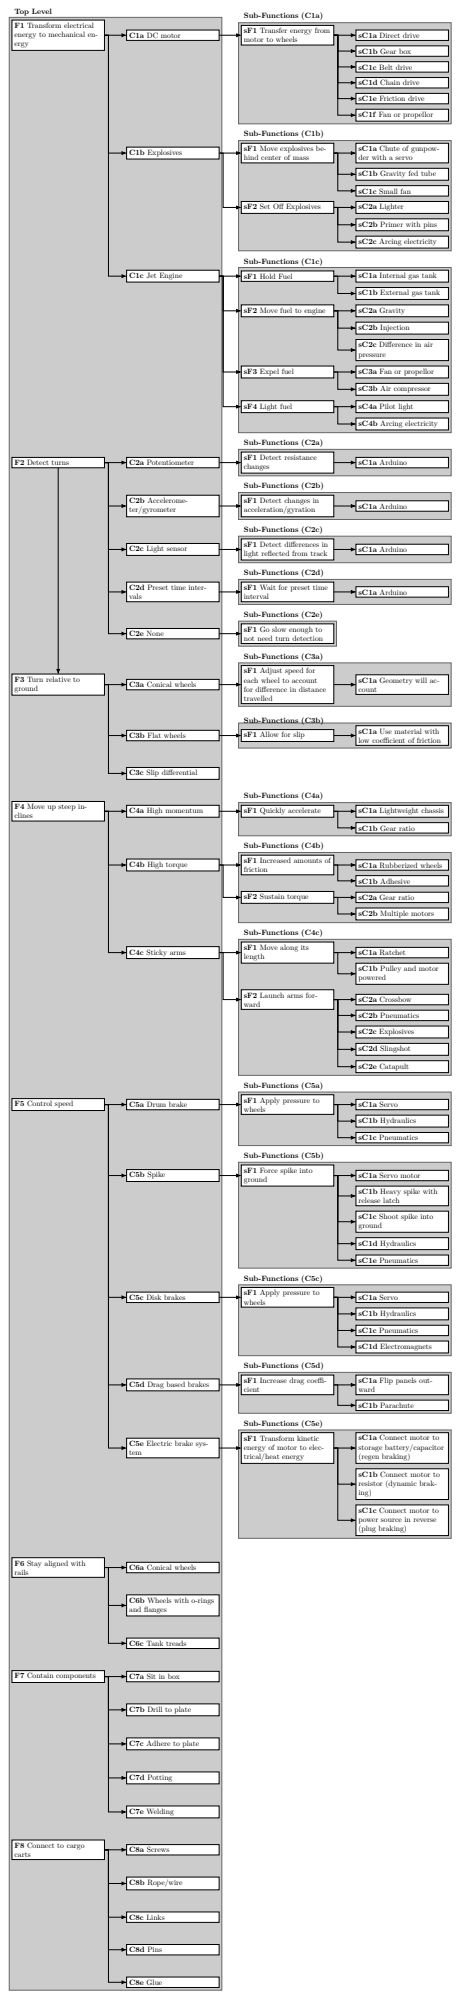
[picture p46: page 1]
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

F1 Transform electrical
energy to mechanical en-
ergy

sC1f Fan or propellor

sC1a Chute of gunpow-
der with a servo

hind center of mass

sC1b Gravity fed tube

sC2b Primer with pins

sC1b External gas tank

sC2c Difference in air
pressure

sF1 Detect changes in

C2d Preset time inter-
vals

sF1 Wait for preset time

not need turn detection

sF1 Adjust speed for
each wheel to account
for difference in distance
travelled

F3 Turn relative to

sC1a Geometry will ac-
count

low coefficient of friction

F4 Move up steep in-

sC1b Pulley and motor
powered

sF2 Launch arms for-

sC1b Heavy spike with
release latch

sC1c Shoot spike into
ground

sC1a Flip panels out-
ward

C5e Electric brake sys-
tem

sF1 Transform kinetic
energy of motor to elec-
trical/heat energy

sC1a Connect motor to
storage battery/capacitor
(regen braking)

sC1b Connect motor to
resistor (dynamic brak-
ing)

sC1c Connect motor to
power source in reverse
(plug braking)

F6 Stay aligned with

C6b Wheels with o-rings
and flanges

C7b Drill to plate

C7c Adhere to plate

F8 Connect to cargo
