Gigahawk/mech223project/Report/bin/labeltest.pdf

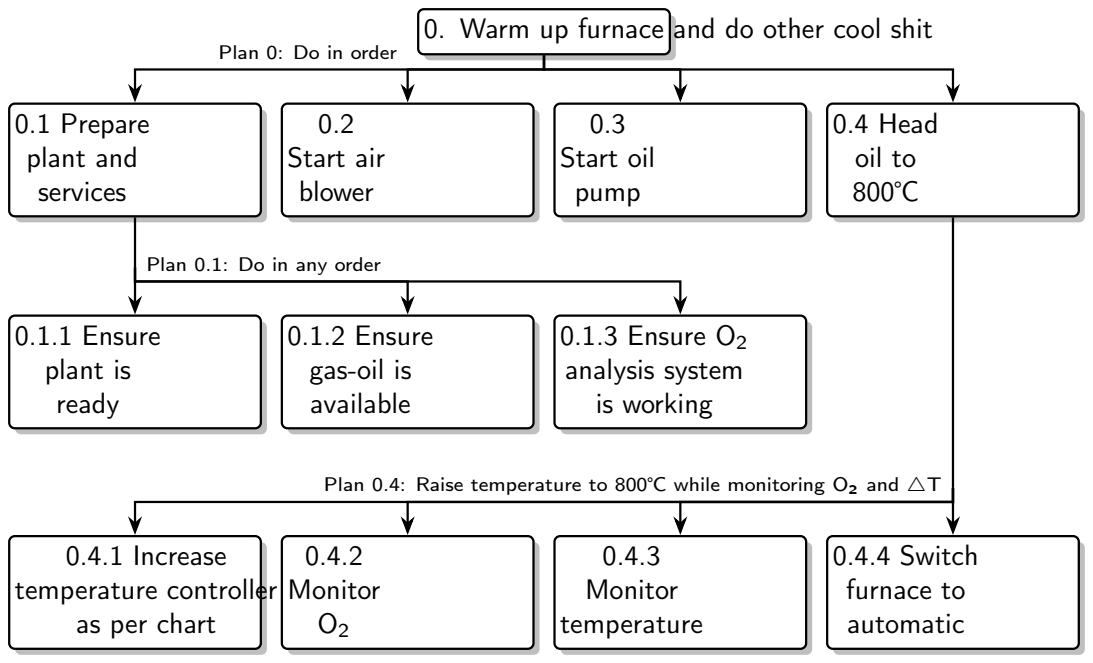
[picture p47: page 1]
0.1 Prepare plant and services; 0.1.1 Ensure plant is ready; 0.1.3 Ensure O2 analysis system is working; 0.2 Start air blower; 0.3 Start oil pump; 0.4 Head oil to 800℃; 0.4.2 Monitor O2; 0.4.3 Monitor temperature; 0.4.4 Switch furnace to automatic

0. Warm up furnace and do other cool shit

Plan 0: Do in order

Plan 0.1: Do in any order

0.1.2 Ensure
gas-oil is
available

Plan 0.4: Raise temperature to 800℃ while monitoring O2 and 4T

0.4.1 Increase
temperature controller
as per chart
