Gigahawk/mech223project/eagle/main.pdf

# 5VGND

# ARDUINO

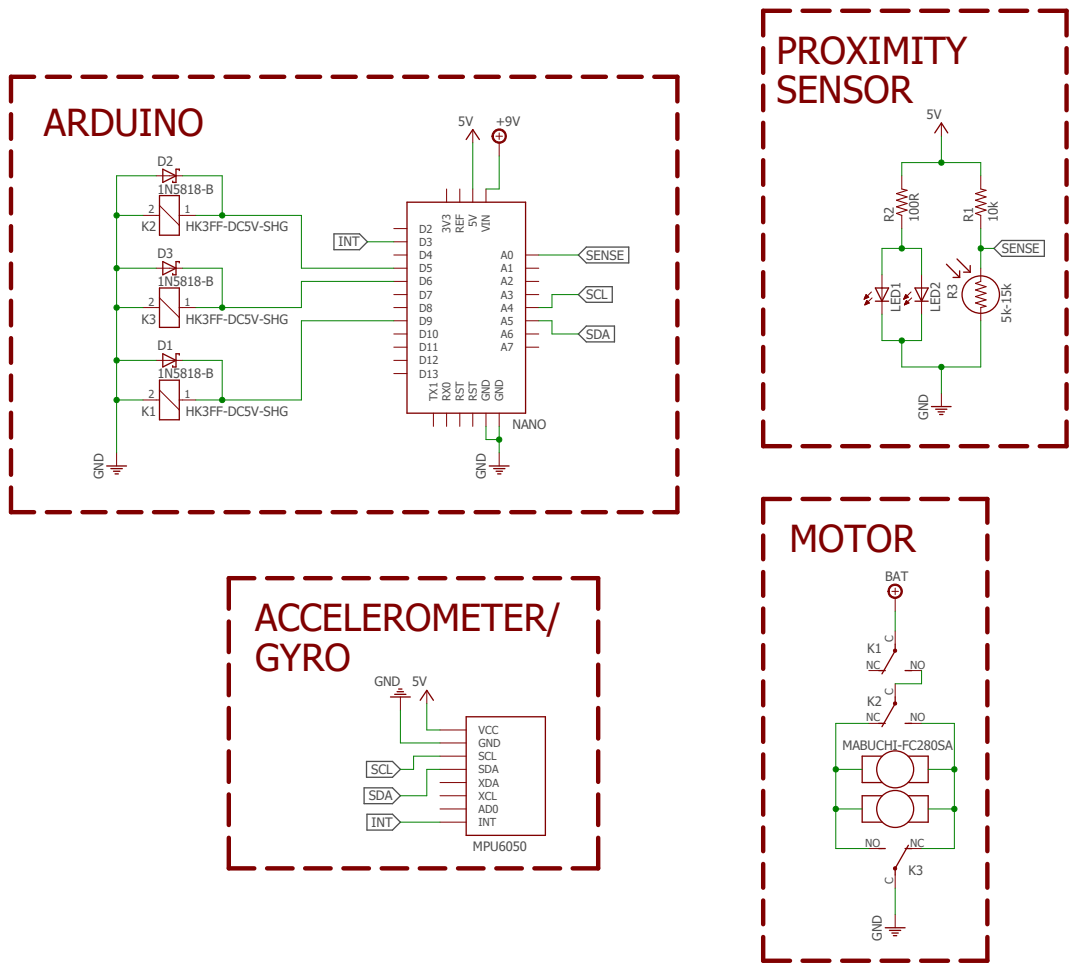
[picture p48: page 1]
