Gigahawk/mech223project/Report/bin/gantt.pdf

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

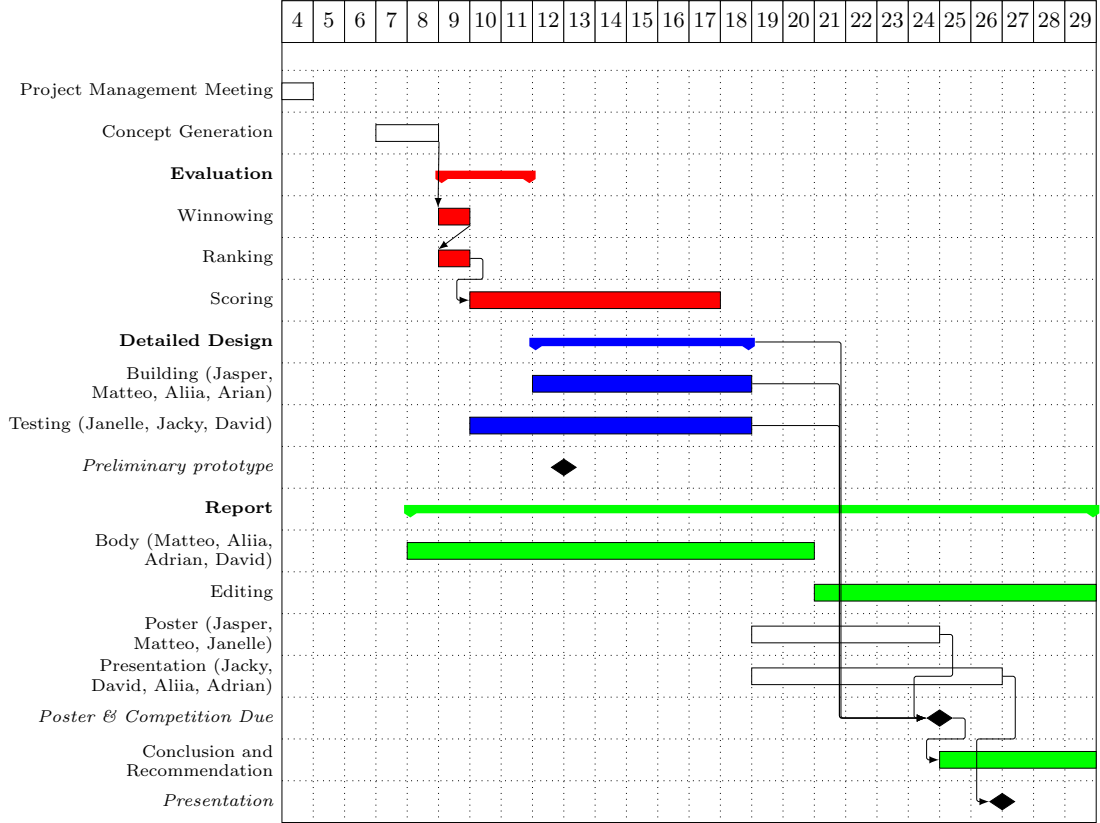
[picture p49: page 1]
Concept Generation; Evaluation; Winnowing; Ranking; Scoring; Detailed Design; Preliminary prototype; Report; Adrian, David); Editing; Conclusion and Recommendation; Presentation

Project Management Meeting

Building (Jasper,
Matteo, Aliia, Arian)

Testing (Janelle, Jacky, David)

Body (Matteo, Aliia,

Poster (Jasper,
Matteo, Janelle)
Presentation (Jacky,
David, Aliia, Adrian)

Poster & Competition Due
