Gigahawk/mech223project/eagle/main.sch

## EAGLE design eagle/main.sch (2018-01-24)

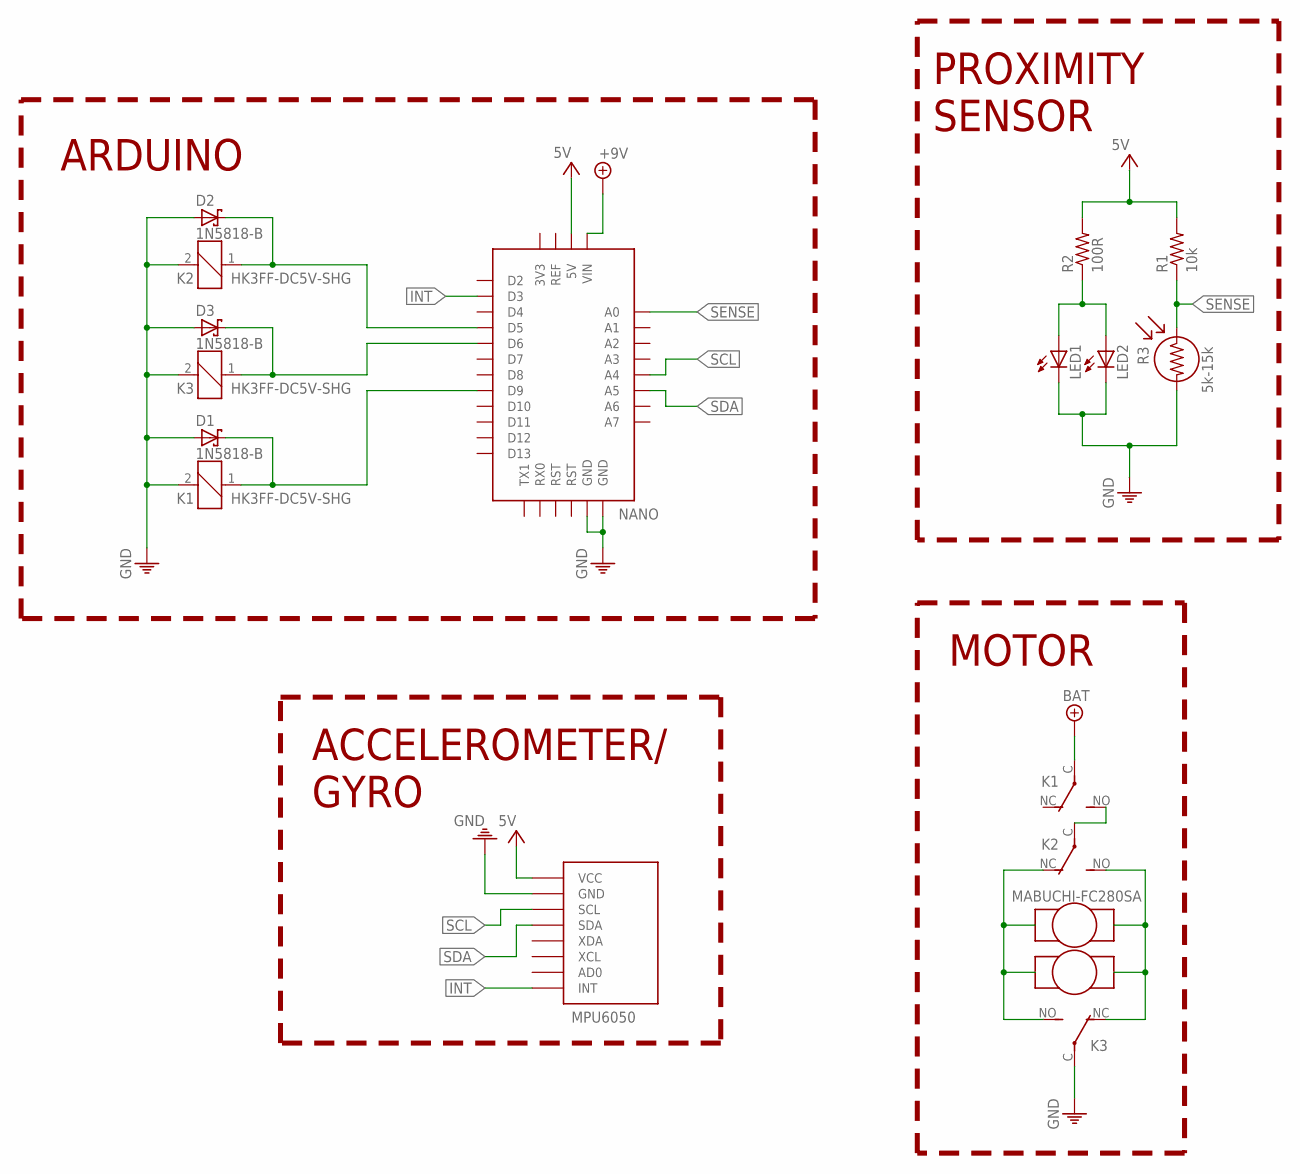
[picture p50: schematic main.sch]

Parts:
D1, D2, D3: 1N5818-B; DO41-7.6
K1, K2, K3: HK3FF-DC5V-SHG; CQ1
LED1, LED2: LAP4-BOTTOM; P47F-BOTTOM
R1: 10k; 0204V
R2: 100R; 0204V
R3: 5k-15k; DC_MOTOR
U$1: NANO; IC
U$2: MPU6050; IC
U$3, U$4: MABUCHI-FC280SA; DC_MOTOR

Connections:
+4.1V: K1.C
+5V: R1.2, R2.2, U$1.P$2 (5V), U$2.P$6 (VCC)
+9V: U$1.P$30 (VIN)
INT: U$1.P$12 (D3), U$2.P$3 (INT)
unnamed: K2.NO (S), K3.NC (O), U$3.P$2, U$4.P$2
unnamed: K2.NC (O), K3.NO (S), U$3.P$1, U$4.P$1
unnamed: K1.NO (S), K2.C
unnamed: D2.C, K2.1, U$1.P$14 (D5)
unnamed: D3.C, K3.1, U$1.P$15 (D6)
unnamed: D1.C, K1.1, U$1.P$18 (D9)
unnamed: LED1.A, LED2.A, R2.1
PE: D1.A, D2.A, D3.A, K1.2, K2.2, K3.2, K3.C, LED1.C, LED2.C, R3.P$2 (2), U$1.P$23 (GND), U$1.P$24 (GND), U$2.P$2 (GND)
SCL: U$1.P$7 (A4), U$2.P$4 (SCL)
SDA: U$1.P$8 (A5), U$2.P$5 (SDA)
SENSE: R1.1, R3.P$1 (1), U$1.P$3 (A0)

Notes on the sheet:
ARDUINO
PROXIMITY SENSOR
ACCELEROMETER/ GYRO
MOTOR
