Gigahawk/mech223project/eagle/motor_comp.SCH

## EAGLE design eagle/motor_comp.SCH (2018-01-24)

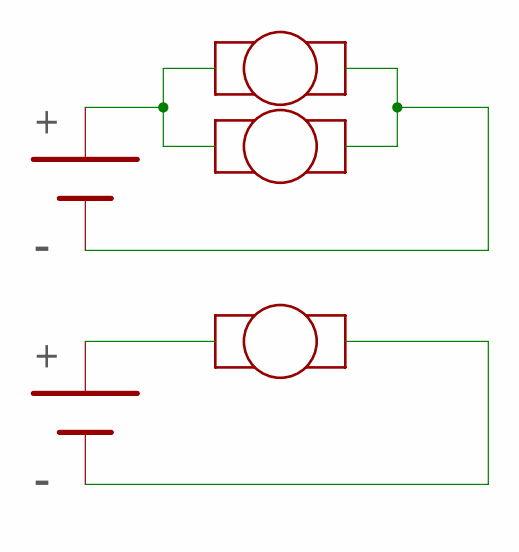
[picture p51: schematic motor_comp.SCH]

Parts:
U$1, U$2, U$5: MABUCHI-FC280SA; DC_MOTOR
U$3, U$6: BATTERY; DC_MOTOR

Connections:
unnamed: U$1.P$1, U$2.P$1, U$3.P$1
unnamed: U$1.P$2, U$2.P$2, U$3.P$2
unnamed: U$5.P$1, U$6.P$1
unnamed: U$5.P$2, U$6.P$2
