Gigahawk/mech223project/(commit log)

2018-01-24 Added other related files
    [main.sch, motor_comp.SCH]
2018-01-24 Added i2cdevlib
2018-01-28 Finished main text of report
    [trainsim.csv, wdm.csv]
2018-01-29 First finished commit
    [lightsensor.csv]
